wntrblm/winterbloom_kicad_library/README.md

# Winterbloom KiCAD libraries

This repository contains common schematic symbols, footprints, and 3D models
used in Winterbloom projects.

* [Symbols](symbols/winterbloom.md)
* [Footprints](footprints/winterbloom.md)

## License

Licensed under [Creative Commons CC-BY-SA 4.0](https://creativecommons.org/licenses/by-sa/4.0/legalcode). See [LICENSE](LICENSE) for more details.
