wntrblm/winterbloom_kicad_library/footprints/winterbloom.md

# Winterbloom

Footprint | Step
---|---
AudioJack_WQP518MA | [AudioJack_WQP518MA](${WINTERBLOOM3DMOD}/WQP-WQP518MA.step)
AudioJack_WQP518MA_Compact_S | [AudioJack_WQP518MA_Compact_S](${WINTERBLOOM3DMOD}/WQP-WQP518MA.step)
AudioJack_WQP518MA_Compact_S_LongPads | [AudioJack_WQP518MA_Compact_S_LongPads](${WINTERBLOOM3DMOD}/WQP-WQP518MA.step)
AudioJack_WQP518MA_LongPads | [AudioJack_WQP518MA_LongPads](${WINTERBLOOM3DMOD}/WQP-WQP518MA.step)
AudioJack_WQP518MA_No_S | [AudioJack_WQP518MA_No_S](${WINTERBLOOM3DMOD}/WQP-WQP518MA.step)
BarrelJack_CUI_PJ-102AH_Horizontal | [BarrelJack_CUI_PJ-102AH_Horizontal](${WINTERBLOOM3DMOD}/CUI_DEVICES_PJ-102A.step)
C_0402_HandSolder | [C_0402_HandSolder](${KICAD6_3DMODEL_DIR}/Capacitor_SMD.3dshapes/C_0402_1005Metric.wrl)
C_0603_HandSolder | [C_0603_HandSolder](${KICAD6_3DMODEL_DIR}/Capacitor_SMD.3dshapes/C_0603_1608Metric.wrl)
C_0805_HandSolder | [C_0805_HandSolder](${KICAD6_3DMODEL_DIR}/Capacitor_SMD.3dshapes/C_0805_2012Metric.wrl)
C_1206_HandSolder | [C_1206_HandSolder](${KICAD6_3DMODEL_DIR}/Capacitor_SMD.3dshapes/C_1206_3216Metric.wrl)
C_1210_HandSolder | [C_1210_HandSolder](${KICAD6_3DMODEL_DIR}/Capacitor_SMD.3dshapes/C_1210_3225Metric.wrl)
Connector_Cortex_Debug_IDC_2x05_P1.27mm_Vertical_Shrouded_SMD | [Connector_Cortex_Debug_IDC_2x05_P1.27mm_Vertical_Shrouded_SMD](${WINTERBLOOM3DMOD}/CNC_Tech_3220-10-0300-00.step)
Connector_FFC_1x05_P2.54mm_Vertical_LongPads | [Connector_FFC_1x05_P2.54mm_Vertical_LongPads]()
Connector_RJ45_ASSMANN_A-2014-2S-4-N-R | [Connector_RJ45_ASSMANN_A-2014-2S-4-N-R](${WINTERBLOOM3DMOD}/ASSMANN_A-2014-4-N-R.step)
Connector_RJ45_SS-7188S-A-PG4-BA-50 | [Connector_RJ45_SS-7188S-A-PG4-BA-50](${WINTERBLOOM3DMOD}/Belfuse-SS-7188S-A-PG4-BA-50.step)
Converter_DCDC_CUI_P78E-1000_THT | [Converter_DCDC_CUI_P78E-1000_THT](${WINTERBLOOM3DMOD}/CUI_P78E12-1000.step)
Converter_DCDC_CUI_V78E05-500-SMT | [Converter_DCDC_CUI_V78E05-500-SMT](${WINTERBLOOM3DMOD}/CUI_V78E05-500-SMT-TR.step)
Converter_DCDC_CUI_VX78-500_THT | [Converter_DCDC_CUI_VX78-500_THT](${WINTERBLOOM3DMOD}/CUI_VX7805-500.step)
Converter_DCDC_Murata_MYRGC | [Converter_DCDC_Murata_MYRGC]()
Crystal_SMD_HC49-US | [Crystal_SMD_HC49-US](${KISYS3DMOD}/Crystal.3dshapes/Crystal_SMD_HC49-SD.wrl)
D_SMA | [D_SMA](${KICAD6_3DMODEL_DIR}/Diode_SMD.3dshapes/D_SMA.wrl)
D_SOD-123 | [D_SOD-123](${WINTERBLOOM3DMOD}/SOD123W.step)
D_SOD-123+SOD-123F | [D_SOD-123+SOD-123F](${KISYS3DMOD}/Diode_SMD.3dshapes/D_SOD-123.wrl)
D_SOD-128 | [D_SOD-128](${WINTERBLOOM3DMOD}/SOD128.step)
D_SOD-323 | [D_SOD-323](${WINTERBLOOM3DMOD}/SOD323.step)
Eurorack_Power_2x5_Shrouded_Lock | [Eurorack_Power_2x5_Shrouded_Lock](${WINTERBLOOM3DMOD}/Eurorack_Power_2x5.step)
Eurorack_Power_2x5_Shrouded_Lock_LongPads | [Eurorack_Power_2x5_Shrouded_Lock_LongPads](${WINTERBLOOM3DMOD}/Eurorack_Power_2x5.step)
Eurorack_Power_2x8_Shrouded_Lock | [Eurorack_Power_2x8_Shrouded_Lock](${KICAD6_3DMODEL_DIR}/Connector_IDC.3dshapes/IDC-Header_2x08_P2.54mm_Vertical.wrl)
Fuse_Littelfuse_0805L | [Fuse_Littelfuse_0805L]()
JST_SH_SM04B-SRSS-TB_1x04-1MP_P1.00mm_Horizontal | [JST_SH_SM04B-SRSS-TB_1x04-1MP_P1.00mm_Horizontal](${WINTERBLOOM3DMOD}/JST-SH-SM04B-SRSS-TB.step)
JST_XH_B3B-XH-AM_1x03_P2.50mm_Vertical | [JST_XH_B3B-XH-AM_1x03_P2.50mm_Vertical](${WINTERBLOOM3DMOD}/JST-XH-B3B-A.step)
JST_XH_B4B-XH-AM_1x04_P2.50mm_Vertical | [JST_XH_B4B-XH-AM_1x04_P2.50mm_Vertical](${WINTERBLOOM3DMOD}/JST-XH-B4B-A.step)
Key_Switch_Cherry_MX_1.00u_PCB | [Key_Switch_Cherry_MX_1.00u_PCB](${WINTERBLOOM3DMOD}/Cherry_MX.step)
LED-APA102-2020 | [LED-APA102-2020](:WINTERBLOOM3DMOD:APA102-2020.step)
LED_0805_Kingbright_APT2012 | [LED_0805_Kingbright_APT2012](${WINTERBLOOM3DMOD}/AP2012.wrl)
LED_APA102_Dotstar_5050 | [LED_APA102_Dotstar_5050](${WINTERBLOOM3DMOD}/APA102_5050.step)
LED_SK9822-EC20_Dotstar_2020 | [LED_SK9822-EC20_Dotstar_2020]()
L_0402_HandSolder | [L_0402_HandSolder](${KICAD6_3DMODEL_DIR}/Inductor_SMD.3dshapes/L_0402_1005Metric.wrl)
L_0603_HandSolder | [L_0603_HandSolder](${KICAD6_3DMODEL_DIR}/Inductor_SMD.3dshapes/L_0603_1608Metric.wrl)
L_0805_HandSolder | [L_0805_HandSolder](${KICAD6_3DMODEL_DIR}/Inductor_SMD.3dshapes/L_0805_2012Metric.wrl)
Miniature_Switch_SPDT_2.54MM | [Miniature_Switch_SPDT_2.54MM]()
MountingHole_M3_Skinny | [MountingHole_M3_Skinny]()
MountingHole_M3_Slotted_Eurorack | [MountingHole_M3_Slotted_Eurorack]()
OSHW-Certification-Mark-Logo_12x6mm_CopperMask | [OSHW-Certification-Mark-Logo_12x6mm_CopperMask]()
OSHW-Certification-Mark-Logo_12x6mm_SilkMask | [OSHW-Certification-Mark-Logo_12x6mm_SilkMask]()
OSHW-Certification-Mark-Logo_12x6mm_SilkScreen | [OSHW-Certification-Mark-Logo_12x6mm_SilkScreen]()
OSHW-Certification-Mark-Logo_20x9mm_CopperMask | [OSHW-Certification-Mark-Logo_20x9mm_CopperMask]()
OSHW-Certification-Mark-Logo_20x9mm_SilkMask | [OSHW-Certification-Mark-Logo_20x9mm_SilkMask]()
OSHW-Certification-Mark-Logo_20x9mm_SilkScreen | [OSHW-Certification-Mark-Logo_20x9mm_SilkScreen]()
OSHW-Certification-Mark-Logo_30x14mm_CopperMask | [OSHW-Certification-Mark-Logo_30x14mm_CopperMask]()
OSHW-Certification-Mark-Logo_30x14mm_SilkMask | [OSHW-Certification-Mark-Logo_30x14mm_SilkMask]()
OSHW-Certification-Mark-Logo_30x14mm_SilkScreen | [OSHW-Certification-Mark-Logo_30x14mm_SilkScreen]()
OSHW-Certification-Mark-Logo_6x3mm_CopperMask | [OSHW-Certification-Mark-Logo_6x3mm_CopperMask]()
OSHW-Certification-Mark-Logo_6x3mm_SilkMask | [OSHW-Certification-Mark-Logo_6x3mm_SilkMask]()
OSHW-Certification-Mark-Logo_6x3mm_SilkScreen | [OSHW-Certification-Mark-Logo_6x3mm_SilkScreen]()
OSHW-Certification-Mark-Logo_8x4mm_CopperMask | [OSHW-Certification-Mark-Logo_8x4mm_CopperMask]()
OSHW-Certification-Mark-Logo_8x4mm_SilkMask | [OSHW-Certification-Mark-Logo_8x4mm_SilkMask]()
OSHW-Certification-Mark-Logo_8x4mm_SilkScreen | [OSHW-Certification-Mark-Logo_8x4mm_SilkScreen]()
OSHW-Certification-Mark-Stacked_12x10mm_CopperMask | [OSHW-Certification-Mark-Stacked_12x10mm_CopperMask]()
OSHW-Certification-Mark-Stacked_12x10mm_SilkMask | [OSHW-Certification-Mark-Stacked_12x10mm_SilkMask]()
OSHW-Certification-Mark-Stacked_12x10mm_SilkScreen | [OSHW-Certification-Mark-Stacked_12x10mm_SilkScreen]()
OSHW-Certification-Mark-Stacked_20x16mm_CopperMask | [OSHW-Certification-Mark-Stacked_20x16mm_CopperMask]()
OSHW-Certification-Mark-Stacked_20x16mm_SilkMask | [OSHW-Certification-Mark-Stacked_20x16mm_SilkMask]()
OSHW-Certification-Mark-Stacked_20x16mm_SilkScreen | [OSHW-Certification-Mark-Stacked_20x16mm_SilkScreen]()
OSHW-Certification-Mark-Stacked_30x24mm_CopperMask | [OSHW-Certification-Mark-Stacked_30x24mm_CopperMask]()
OSHW-Certification-Mark-Stacked_30x24mm_SilkMask | [OSHW-Certification-Mark-Stacked_30x24mm_SilkMask]()
OSHW-Certification-Mark-Stacked_30x24mm_SilkScreen | [OSHW-Certification-Mark-Stacked_30x24mm_SilkScreen]()
OSHW-Certification-Mark-Stacked_8x7mm_CopperMask | [OSHW-Certification-Mark-Stacked_8x7mm_CopperMask]()
OSHW-Certification-Mark-Stacked_8x7mm_SilkMask | [OSHW-Certification-Mark-Stacked_8x7mm_SilkMask]()
OSHW-Certification-Mark-Stacked_8x7mm_SilkScreen | [OSHW-Certification-Mark-Stacked_8x7mm_SilkScreen]()
OSHW-Certification-Mark-Wide_4x25mm_CopperMask | [OSHW-Certification-Mark-Wide_4x25mm_CopperMask]()
OSHW-Certification-Mark-Wide_4x25mm_SilkMask | [OSHW-Certification-Mark-Wide_4x25mm_SilkMask]()
OSHW-Certification-Mark-Wide_4x25mm_SilkScreen | [OSHW-Certification-Mark-Wide_4x25mm_SilkScreen]()
OSHW-Certification-Mark-Wide_6x35mm_CopperMask | [OSHW-Certification-Mark-Wide_6x35mm_CopperMask]()
OSHW-Certification-Mark-Wide_6x35mm_SilkMask | [OSHW-Certification-Mark-Wide_6x35mm_SilkMask]()
OSHW-Certification-Mark-Wide_6x35mm_SilkScreen | [OSHW-Certification-Mark-Wide_6x35mm_SilkScreen]()
OSHW-Certification-Mark-Wide_9x45mm_CopperMask | [OSHW-Certification-Mark-Wide_9x45mm_CopperMask]()
OSHW-Certification-Mark-Wide_9x45mm_SilkMask | [OSHW-Certification-Mark-Wide_9x45mm_SilkMask]()
OSHW-Certification-Mark-Wide_9x45mm_SilkScreen | [OSHW-Certification-Mark-Wide_9x45mm_SilkScreen]()
Potentiometer_Alpha_R0904N | [Potentiometer_Alpha_R0904N](${WINTERBLOOM3DMOD}/Alpha-RD901F-40-15R1.step)
Potentiometer_Alpha_R0904N_LongPads | [Potentiometer_Alpha_R0904N_LongPads](${WINTERBLOOM3DMOD}/Alpha-RD901F-40-15R1.step)
Potentiometer_Bourns_PTA45x3-2x | [Potentiometer_Bourns_PTA45x3-2x](${WINTERBLOOM3DMOD}/Bourns_PTA4543.step)
Potentiometer_Moog | [Potentiometer_Moog]()
QFN-20-3x5mm_MPM3610GQV | [QFN-20-3x5mm_MPM3610GQV]()
RJ45_Amphenol_RJE45-188-1411_Vertical | [RJ45_Amphenol_RJE45-188-1411_Vertical](${WINTERBLOOM3DMOD}/Amphenol-RJE45-188-1xx1.step)
RP2040-QFN-56 | [RP2040-QFN-56](${WINTERBLOOM3DMOD}/RP2040.step)
R_0402_HandSolder | [R_0402_HandSolder](${KICAD6_3DMODEL_DIR}/Resistor_SMD.3dshapes/R_0402_1005Metric.wrl)
R_0603_HandSolder | [R_0603_HandSolder](${KICAD6_3DMODEL_DIR}/Resistor_SMD.3dshapes/R_0603_1608Metric.wrl)
R_0805_HandSolder | [R_0805_HandSolder](${KICAD6_3DMODEL_DIR}/Resistor_SMD.3dshapes/R_0805_2012Metric.wrl)
R_1206_HandSolder | [R_1206_HandSolder](${KICAD6_3DMODEL_DIR}/Resistor_SMD.3dshapes/R_1206_3216Metric.wrl)
R_1210_HandSolder | [R_1210_HandSolder](${KICAD6_3DMODEL_DIR}/Resistor_SMD.3dshapes/R_1210_3225Metric.wrl)
SOIC-8+DMP-8_5mmx5mm_P1.27mm | [SOIC-8+DMP-8_5mmx5mm_P1.27mm](${KICAD8_3DMODEL_DIR}/Package_SO.3dshapes/SOIC-8_3.9x4.9mm_P1.27mm.wrl)
SolderWirePad_1x04_SMD_2x5mm | [SolderWirePad_1x04_SMD_2x5mm]()
Switch_DPDT_Thonk_DW4_P2.54mm | [Switch_DPDT_Thonk_DW4_P2.54mm]()
Symbol_CE_5x3.5mm_SilkScreen | [Symbol_CE_5x3.5mm_SilkScreen]()
Symbol_Ermine_15mm | [Symbol_Ermine_15mm]()
Symbol_Winterbloom_25mm | [Symbol_Winterbloom_25mm]()
Symbol_Winterbloom_40mm | [Symbol_Winterbloom_40mm]()
TDFN-8-1EP_MAX9717xET | [TDFN-8-1EP_MAX9717xET]()
TI-DGN-HVSSOP-8_3.0x3.0mm_P0.65mm | [TI-DGN-HVSSOP-8_3.0x3.0mm_P0.65mm](${KISYS3DMOD}/Package_SO.3dshapes/VSSOP-8_3.0x3.0mm_P0.65mm.wrl)
TMC2209-LA | [TMC2209-LA](${WINTERBLOOM3DMOD}/TMC2209_QFN28_5x5mm.step)
TQFP-48_7x7mm_P0.5mm | [TQFP-48_7x7mm_P0.5mm](${KISYS3DMOD}/Package_QFP.3dshapes/TQFP-48_7x7mm_P0.5mm.wrl)
Tactile_Switch_4.2mm | [Tactile_Switch_4.2mm](${WINTERBLOOM3DMOD}/Tactile_Switch_4.2mm.step)
Tactile_Switch_6mm | [Tactile_Switch_6mm](${WINTERBLOOM3DMOD}/E-Switch_TL1105TFxxxx.step)
Tag_Connect_TC2030NL | [Tag_Connect_TC2030NL]()
TerminalBlock_4UCON_1x02_P3.50mm_Horizontal | [TerminalBlock_4UCON_1x02_P3.50mm_Horizontal](${WINTERBLOOM3DMOD}/Terminal_Block_01x02.step)
TerminalBlock_CUI_TB002-500_1x02_P5.00mm_Vertical | [TerminalBlock_CUI_TB002-500_1x02_P5.00mm_Vertical](${WINTERBLOOM3DMOD}/CUI_DEVICES_TB002-500-02BE.step)
USB_B_Micro_Receptacle | [USB_B_Micro_Receptacle](${WINTERBLOOM3DMOD}/USB_B_Micro_Receptacle.igs)
USB_B_Receptacle | [USB_B_Receptacle](${WINTERBLOOM3DMOD}/USB_B_Receptacle.step)
USB_B_Receptacle_Horizontal | [USB_B_Receptacle_Horizontal](${WINTERBLOOM3DMOD}/Stewart-SS-52300-001.step)
USB_C_Vertical_GT-USB-7038X | [USB_C_Vertical_GT-USB-7038X](:WINTERBLOOM3DMOD:G-Switch_GT-USB-7038B.step)
Vishay_SOT-23_8 | [Vishay_SOT-23_8](${KICAD6_3DMODEL_DIR}/Package_TO_SOT_SMD.3dshapes/TSOT-23-8.wrl)
XGZP6857D | [XGZP6857D](${WINTERBLOOM3DMOD}/XGZP6857D.step)
IND_1255AY-220M=P3 | [IND_1255AY-220M=P3]()
IND_SDR0403-180ML | [IND_SDR0403-180ML]()
QFN+QFP-64-SAMD51 | [QFN+QFP-64-SAMD51](${KISYS3DMOD}/Package_DFN_QFN.3dshapes/QFN-64-1EP_9x9mm_P0.5mm_EP3.8x3.8mm.wrl)
