wntrblm/winterbloom_kicad_library/symbols/winterbloom.md

# Winterbloom

Symbol | Datasheet | Footprint
---|---|---
74HC2G34 | [74HC2G34](https://assets.nexperia.com/documents/data-sheet/74HC_HCT2G34.pdf) | Package_TO_SOT_SMD:SOT-363_SC-70-6
74LVC1G04 | [74LVC1G04](https://www.ti.com/lit/ds/symlink/sn74lvc1g04.pdf) | Package_TO_SOT_SMD:SOT-23-5
74LVC2G74 | [74LVC2G74](https://assets.nexperia.com/documents/data-sheet/74LVC2G74.pdf) | 
8.0 | [8.0]() | 
AD5686RxRUZ | [AD5686RxRUZ](https://www.analog.com/media/en/technical-documentation/data-sheets/ad5686r_5685r_5684r.pdf) | Package_SO:TSSOP-16_4.4x5mm_P0.65mm
ADG1208 | [ADG1208](https://www.analog.com/media/en/technical-documentation/data-sheets/ADG1208_1209.pdf) | Package_SO:TSSOP-16_4.4x5mm_P0.65mm
ADG1209 | [ADG1209](https://www.analog.com/media/en/technical-documentation/data-sheets/ADG1208_1209.pdf) | Package_SO:TSSOP-16_4.4x5mm_P0.65mm
ADG1308 | [ADG1308](https://www.analog.com/media/en/technical-documentation/data-sheets/ADG1308_1309.pdf) | Package_SO:TSSOP-16_4.4x5mm_P0.65mm
ADG1309 | [ADG1309](https://www.analog.com/media/en/technical-documentation/data-sheets/ADG1308_1309.pdf) | Package_SO:TSSOP-16_4.4x5mm_P0.65mm
APA102-2020_Dotstar | [APA102-2020_Dotstar](https://cdn-shop.adafruit.com/product-files/3341/3341_APA102-2020+SMD+LED.pdf) | LED_SMD:LED-APA102-2020
ATSAMD21G18A-A | [ATSAMD21G18A-A](http://ww1.microchip.com/downloads/en/DeviceDoc/SAM_D21_DA1_Family_Data%20Sheet_DS40001882E.pdf) | winterbloom:TQFP-48_7x7mm_P0.5mm
ATSAMD51J20A-M | [ATSAMD51J20A-M](https://ww1.microchip.com/downloads/en/DeviceDoc/SAM_D5x_E5x_Family_Data_Sheet_DS60001507G.pdf) | Package_DFN_QFN:QFN-64-1EP_9x9mm_P0.5mm_EP3.8x3.8mm
ATSAMD51P20A-A | [ATSAMD51P20A-A](http://ww1.microchip.com/downloads/en/DeviceDoc/60001507E.pdf) | Package_QFP:TQFP-128_14x14mm_P0.4mm
BCM847 | [BCM847](https://assets.nexperia.com/documents/data-sheet/BCM847BS.pdf) | Package_TO_SOT_SMD:SOT-363_SC-70-6
Conn_01x04_MountingPin2 | [Conn_01x04_MountingPin2](~) | Connector_JST:JST_PH_S4B-PH-SM4-TB_1x04-1MP_P2.00mm_Horizontal
Conn_SWD | [Conn_SWD](http://infocenter.arm.com/help/topic/com.arm.doc.ddi0314h/DDI0314H_coresight_components_trm.pdf) | winterbloom:Connector_Cortex_Debug_IDC_2x05_P1.27mm_Vertical_Shrouded_SMD
Crystal_12MHz_4Pin | [Crystal_12MHz_4Pin](https://abracon.com/datasheets/ABM8G-106-12.000MHz-T.pdf) | Crystal:Crystal_SMD_Abracon_ABM8G-4Pin_3.2x2.5mm
DG449 | [DG449](https://www.vishay.com/docs/73897/dg449.pdf) | winterbloom:Vishay_SOT-23_8
DRV103U | [DRV103U](https://www.ti.com/lit/ds/symlink/drv103.pdf) | Package_SO:SOIC-8_3.9x4.9mm_P1.27mm
DRV120PWR | [DRV120PWR](https://www.ti.com/lit/ds/symlink/drv120.pdf) | Package_SO:TSSOP-8_4.4x3mm_P0.65mm
Dotstar | [Dotstar](https://www.alibaba.com/product-detail/High-Efficiency-SK9822-Similar-APA102-5050_62326807400.html) | winterbloom:LED_APA102_Dotstar_5050
Eurorack_Mono_Jack | [Eurorack_Mono_Jack](http://www.qingpu-electronics.com/en/products/WQP-PJ398SM-362.html) | winterbloom:AudioJack_WQP518MA
Eurorack_Mono_Jack_No_S | [Eurorack_Mono_Jack_No_S](http://www.qingpu-electronics.com/en/products/WQP-PJ398SM-362.html) | winterbloom:AudioJack_WQP518MA_No_S
Eurorack_Pot | [Eurorack_Pot](https://s3.us-west-2.amazonaws.com/secure.notion-static.com/c2e29654-9937-4f21-ad37-19aeb30b6cf7/R0904N%28KQ%29-LWS.pdf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) | winterbloom:Potentiometer_Alpha_R0904N
Eurorack_Power | [Eurorack_Power](https://static6.arrow.com/aropdfconversion/1507f1621f4e67855dd466ebb3ac550d52564a9d/32302-sxx1.pdf) | winterbloom:Eurorack_Power_2x5_Shrouded_Lock
GD25Q64CWIGR | [GD25Q64CWIGR](http://www.gigadevice.com/datasheet/gd25q64c/) | Package_SON:WSON-8-1EP_6x5mm_P1.27mm_EP3.4x4mm
LM1117-3.3 | [LM1117-3.3](http://www.ti.com/lit/ds/symlink/lm1117.pdf) | Package_TO_SOT_SMD:SOT-223-3_TabPin2
LM358PWR | [LM358PWR](https://www.ti.com/lit/ds/symlink/lm358.pdf) | Package_SO:TSSOP-8_4.4x3mm_P0.65mm
LM4040-10 | [LM4040-10](http://www.ti.com/lit/ds/symlink/lm4040-n.pdf) | Package_TO_SOT_SMD:SOT-23
LM4040DBZ-10 | [LM4040DBZ-10](http://www.ti.com/lit/ds/symlink/lm4040-n.pdf) | Package_TO_SOT_SMD:SOT-23
LSM6DSO | [LSM6DSO](https://www.st.com/resource/en/datasheet/lsm6dso.pdf) | Package_LGA:LGA-14_3x2.5mm_P0.5mm_LayoutBorder3x4y
MAX9717x | [MAX9717x](https://datasheets.maximintegrated.com/en/ds/MAX9716-MAX9717.pdf) | winterbloom:TDFN-8-1EP_MAX9717xET
MAX97220C | [MAX97220C](https://www.mouser.com/datasheet/2/256/MAX97220A-MAX97220E-5002.pdf) | Package_DFN_QFN:TQFN-16-1EP_3x3mm_P0.5mm_EP1.23x1.23mm_ThermalVias
MAX98357A | [MAX98357A](https://datasheets.maximintegrated.com/en/ds/MAX98357A-MAX98357B.pdf) | Package_DFN_QFN:QFN-16-1EP_3x3mm_P0.5mm_EP1.45x1.45mm
MCP4728 | [MCP4728](http://ww1.microchip.com/downloads/en/DeviceDoc/22187E.pdf) | Package_SO:MSOP-10_3x3mm_P0.5mm
MCP6001-OT | [MCP6001-OT](http://ww1.microchip.com/downloads/en/DeviceDoc/22141b.pdf) | Package_TO_SOT_SMD:SOT-23-5
MCP6002 | [MCP6002](https://ww1.microchip.com/downloads/en/DeviceDoc/MCP6001-1R-1U-2-4-1-MHz-Low-Power-Op-Amp-DS20001733L.pdf) | Package_SO:MSOP-8_3x3mm_P0.65mm
MCP6004 | [MCP6004](http://datasheet.octopart.com/MCP6001T-I/OT-Microchip-datasheet-8823409.pdf) | Package_SO:TSSOP-14_4.4x5mm_P0.65mm
MIC5317 | [MIC5317](https://www.mouser.com/datasheet/2/268/MIC5317_High_Performance_Single_150mA_LDO_DS200061-1891237.pdf) | Package_TO_SOT_SMD:SOT-23-5
MIC5319 | [MIC5319](https://ww1.microchip.com/downloads/en/DeviceDoc/500mA-uCap-Ultra-Low-Dropout-Regulator-with-High-PSRR-DS20005876B.pdf) | Package_TO_SOT_SMD:SOT-23-5
MPM3610 | [MPM3610](https://www.monolithicpower.com/en/mpm3610.html) | 
MUX508 | [MUX508](https://www.ti.com/lit/ds/symlink/mux508.pdf) | Package_SO:TSSOP-16_4.4x5mm_P0.65mm
MUX509 | [MUX509](https://www.ti.com/lit/ds/symlink/mux509.pdf) | Package_SO:TSSOP-16_4.4x5mm_P0.65mm
MYRGC | [MYRGC](https://www.mouser.com/datasheet/2/281/MYRGC-1701768.pdf) | 
OPA4197 | [OPA4197](https://www.ti.com/lit/ds/symlink/opa4197.pdf) | Package_SO:TSSOP-14_4.4x5mm_P0.65mm
OPA4991 | [OPA4991](https://www.ti.com/lit/ds/symlink/opa4991.pdf) | Package_SO:TSSOP-14_4.4x5mm_P0.65mm
P78E-1000 | [P78E-1000](https://www.mouser.com/datasheet/2/670/p78e_1000-1480573.pdf) | 
PAM8302AAS | [PAM8302AAS](https://www.diodes.com/assets/Datasheets/PAM8302A.pdf) | winterbloom:TDFN-8-1EP_MAX9717xET
PCA9545 | [PCA9545](https://www.nxp.com/docs/en/data-sheet/PCA9545A_45B_45C.pdf) | Package_SO:TSSOP-20_4.4x6.5mm_P0.65mm
RP2040 | [RP2040](https://datasheets.raspberrypi.com/rp2040/rp2040-datasheet.pdf) | winterbloom:RP2040-QFN-56
SSM2604 | [SSM2604](https://www.analog.com/media/en/technical-documentation/data-sheets/SSM2604.pdf) | Package_CSP:LFCSP-20-1EP_4x4mm_P0.5mm_EP2.6x2.6mm
Switch_3PDT | [Switch_3PDT](~) | 
TC1044SxOA | [TC1044SxOA](http://ww1.microchip.com/downloads/en/DeviceDoc/21469a.pdf) | Package_SO:SOIC-8_3.9x4.9mm_P1.27mm
TL074 | [TL074](https://www.ti.com/lit/ds/symlink/tl071.pdf) | Package_SO:TSSOP-14_4.4x5mm_P0.65mm
TLV76733 | [TLV76733](https://www.ti.com/lit/ds/symlink/tlv767.pdf) | Package_SO:VSSOP-8_3.0x3.0mm_P0.65mm
TMC2209 | [TMC2209]() | 
TMUX6208 | [TMUX6208](https://www.ti.com/lit/ds/symlink/tmux6208.pdf) | Package_SO:TSSOP-16_4.4x5mm_P0.65mm
TMUX6209 | [TMUX6209](https://www.ti.com/lit/ds/symlink/tmux6209.pdf) | Package_SO:TSSOP-16_4.4x5mm_P0.65mm
TPD2EUSB30A | [TPD2EUSB30A](http://www.ti.com/lit/ds/symlink/tpd2eusb30a.pdf) | Package_TO_SOT_SMD:Texas_DRT-3
Tactile_Switch | [Tactile_Switch](https://factory.macrofab.com/part/MF-SW-TACT-4.2MM) | winterbloom:Tactile_Switch_4.2mm
Tag-Connect_SWD_TC2030 | [Tag-Connect_SWD_TC2030](https://www.tag-connect.com/product/tc2030-ctx-nl-6-pin-no-legs-cable-with-10-pin-micro-connector-for-cortex-processors~) | winterbloom:Tag_Connect_TC2030NL
USBLC6-2SC6 | [USBLC6-2SC6](https://www.st.com/resource/en/datasheet/usblc6-2.pdf) | Package_TO_SOT_SMD:SOT-23-6
USB_B_Micro_Receptacle | [USB_B_Micro_Receptacle](https://cdn.amphenol-cs.com/media/wysiwyg/files/documentation/datasheet/inputoutput/io_usb_micro.pdf) | winterbloom:USB_B_Micro_Receptacle
USB_B_Receptacle | [USB_B_Receptacle](https://www.te.com/commerce/DocumentDelivery/DDEController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) | winterbloom:USB_B_Receptacle
USB_C_Receptacle_USB2.0 | [USB_C_Receptacle_USB2.0](https://www.usb.org/sites/default/files/documents/usb_type-c.zip) | 
V78E05-500-SMT | [V78E05-500-SMT](https://www.cui.com/product/resource/v78e-500-smt.pdf) | winterbloom:V78E05-500-SMT
VX7805-500 | [VX7805-500](https://www.mouser.com/datasheet/2/670/vx78_500-1774570.pdf) | 
W25Q128JVSIQ | [W25Q128JVSIQ](https://www.winbond.com/resource-files/w25q128jv%20revf%2003272018%20plus.pdf) | Package_SO:SOIC-8_5.23x5.23mm_P1.27mm
XGZP6857D | [XGZP6857D](https://www.cfsensor.com/static/upload/file/20220412/XGZP6857D%20Pressure%20Sensor%20Module%20V2.4.pdf) | winterbloom:XGZP6857D
