wntrblm/winterbloom_kicad_library/3dmodels/CUI_V78E05-500-SMT.step

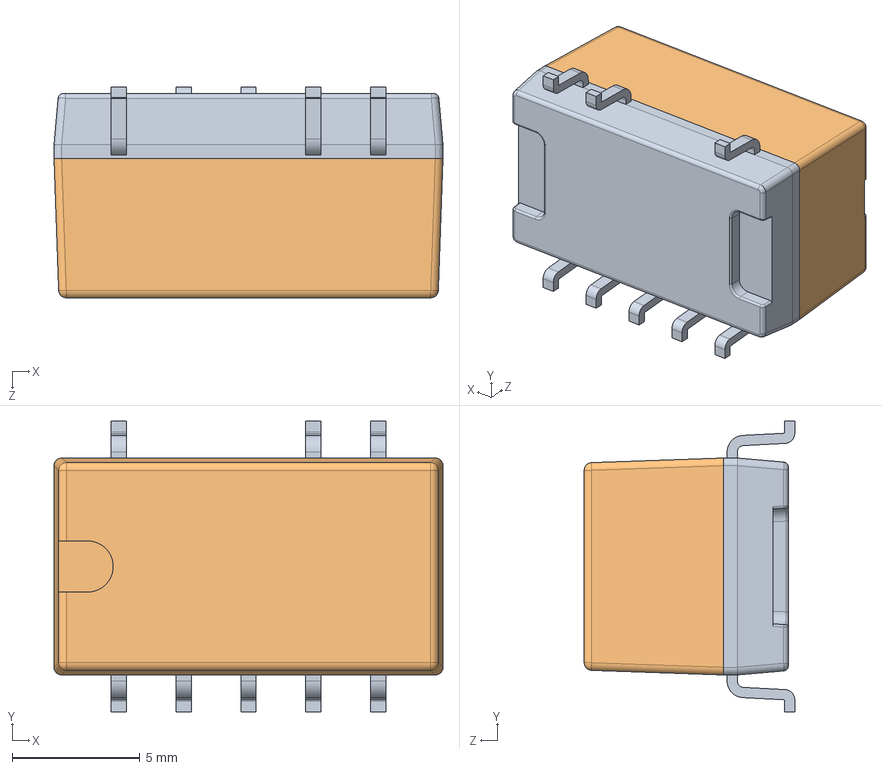
[picture p1: CAD file, 2024-07-16]
3dmodels/CUI_V78E05-500-SMT.step
15.2 x 11.4 x 8.25 mm
