wntrblm/winterbloom_kicad_library/3dmodels/Alps_RK09L12-L15V.step

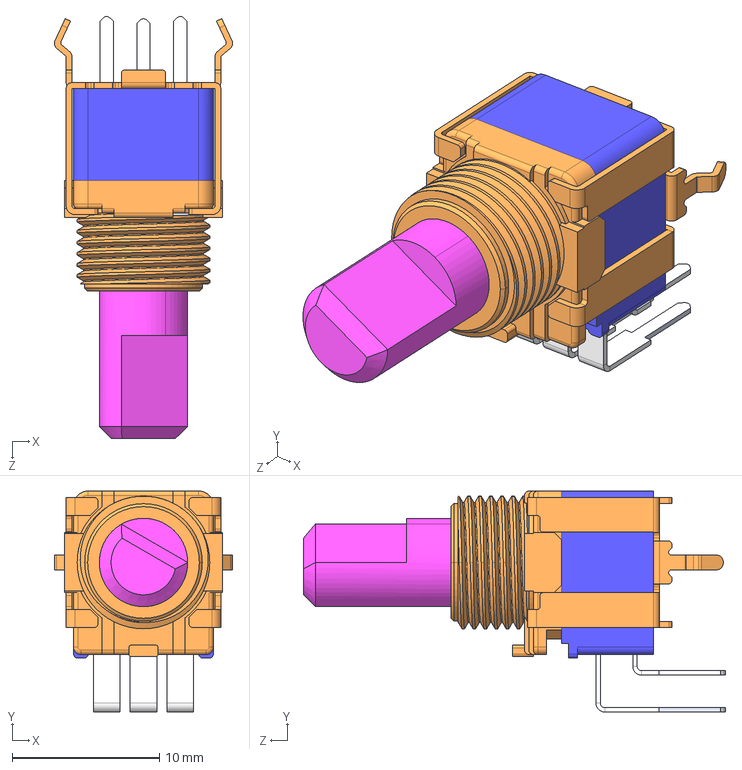
[picture p2: CAD file, 2024-07-16]
3dmodels/Alps_RK09L12-L15V.step
12.1 x 15.0 x 28.6 mm
