wntrblm/winterbloom_kicad_library/3dmodels/Neutrik_NMJ4HCD2.step

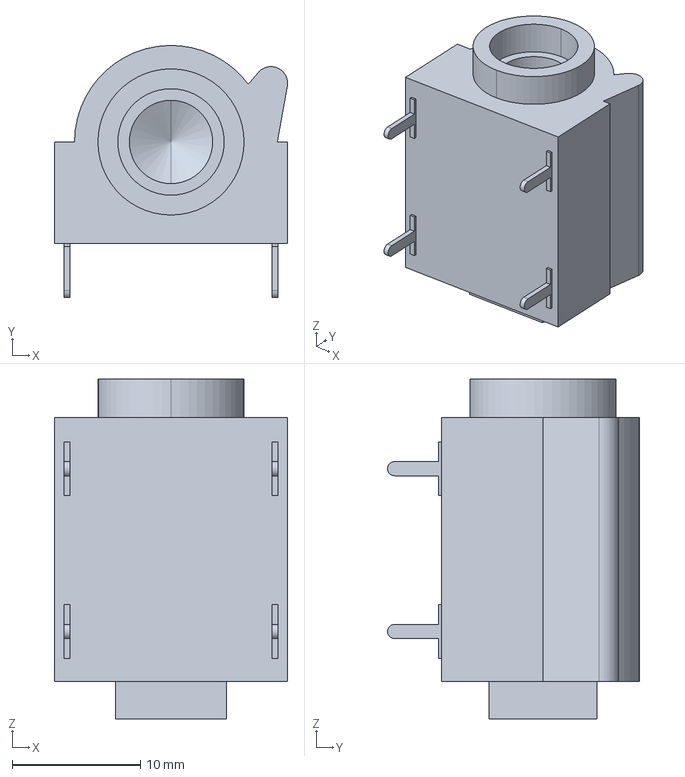
[picture p3: CAD file, 2024-02-03]
3dmodels/Neutrik_NMJ4HCD2.step
18.2 x 19.7 x 26.5 mm
