wntrblm/winterbloom_kicad_library/3dmodels/APA102-2020.step

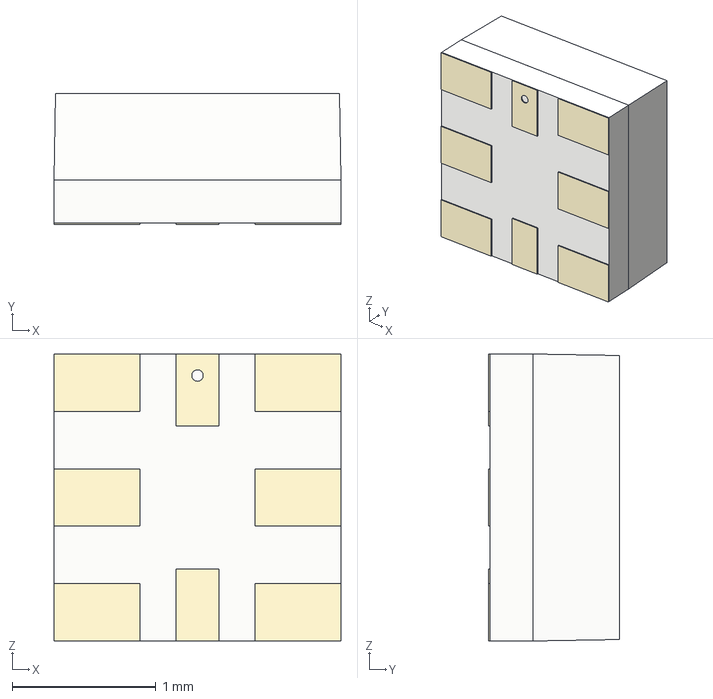
[picture p4: CAD file, 2023-09-24]
3dmodels/APA102-2020.step
2.00 x 0.91 x 2.00 mm
