wntrblm/winterbloom_kicad_library/3dmodels/JST-SH-SM05B-SRSS-TB.step

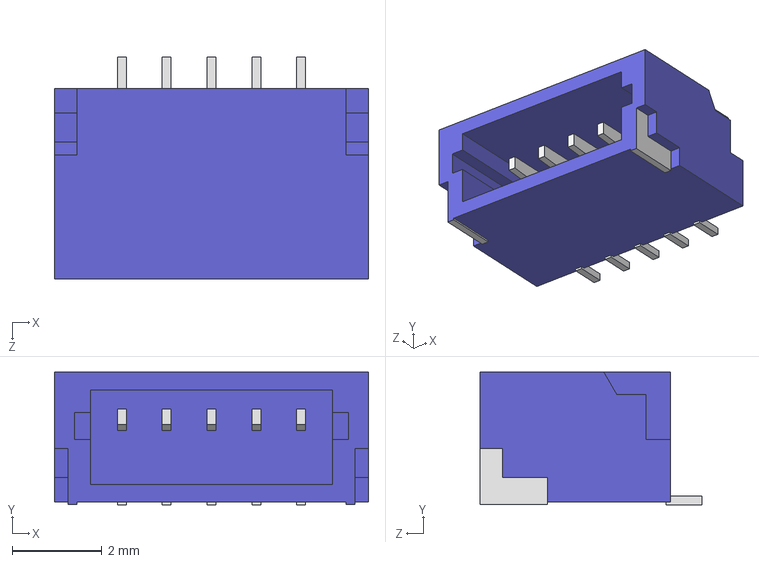
[picture p5: CAD file, 2023-09-24]
3dmodels/JST-SH-SM05B-SRSS-TB.step
7.00 x 2.96 x 4.95 mm
