wntrblm/winterbloom_kicad_library/3dmodels/G-Switch_GT-USB-7038D.step

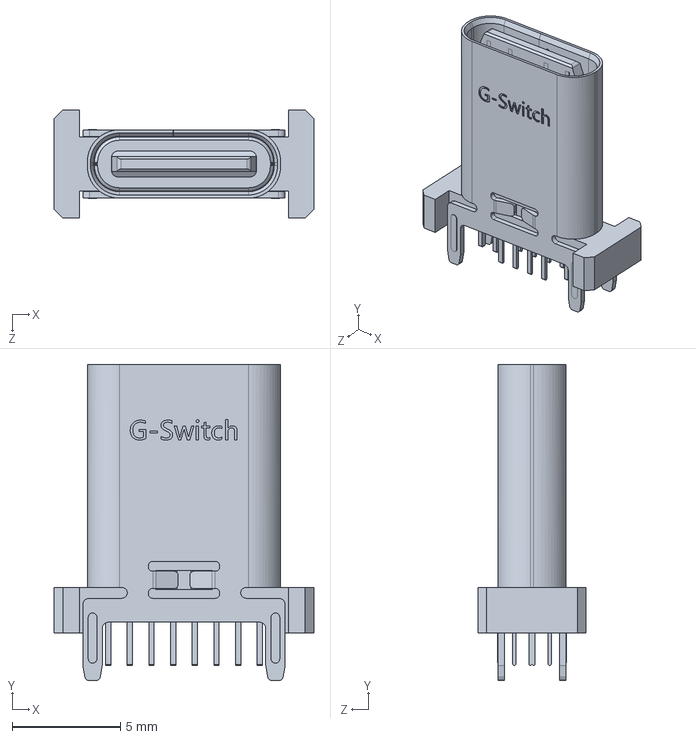
[picture p6: CAD file, 2023-09-23]
3dmodels/G-Switch_GT-USB-7038D.step
12.0 x 14.6 x 5.00 mm
