wntrblm/winterbloom_kicad_library/3dmodels/G-Switch_GT-USB-7038B.step

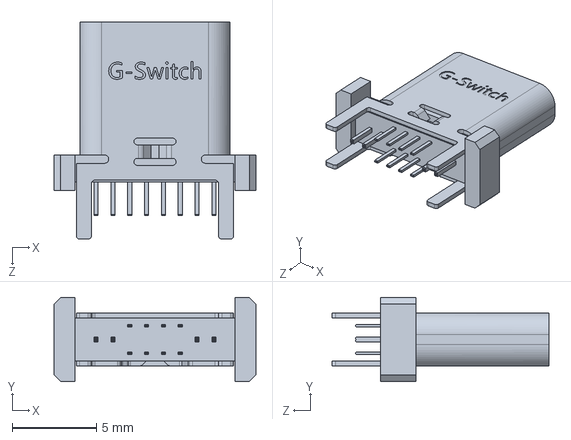
[picture p7: CAD file, 2023-09-23]
3dmodels/G-Switch_GT-USB-7038B.step
12.0 x 5.00 x 12.9 mm
