wntrblm/winterbloom_kicad_library/3dmodels/WQP-WQP518MA.step

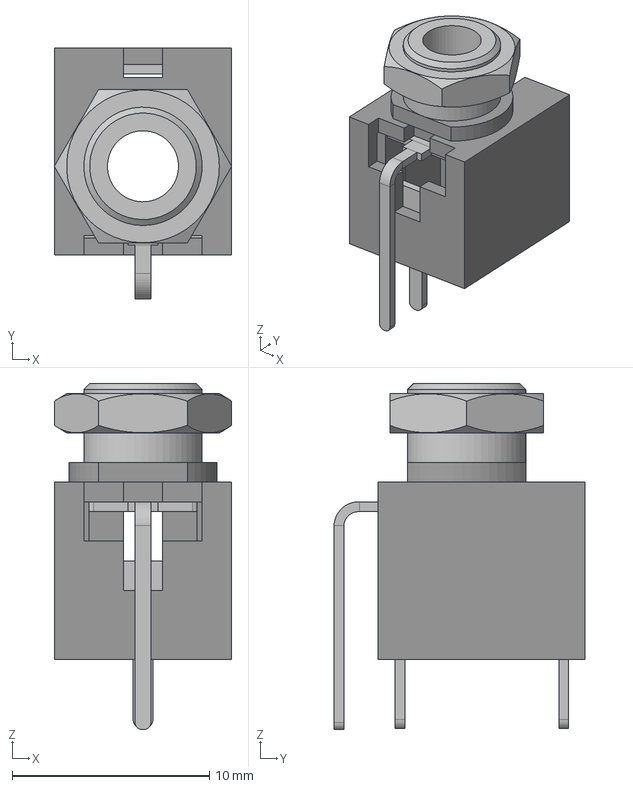
[picture p8: CAD file, 2023-08-08]
3dmodels/WQP-WQP518MA.step
9.00 x 12.7 x 17.6 mm
