wntrblm/winterbloom_kicad_library/3dmodels/E-Switch_TL1105TFxxxx.step

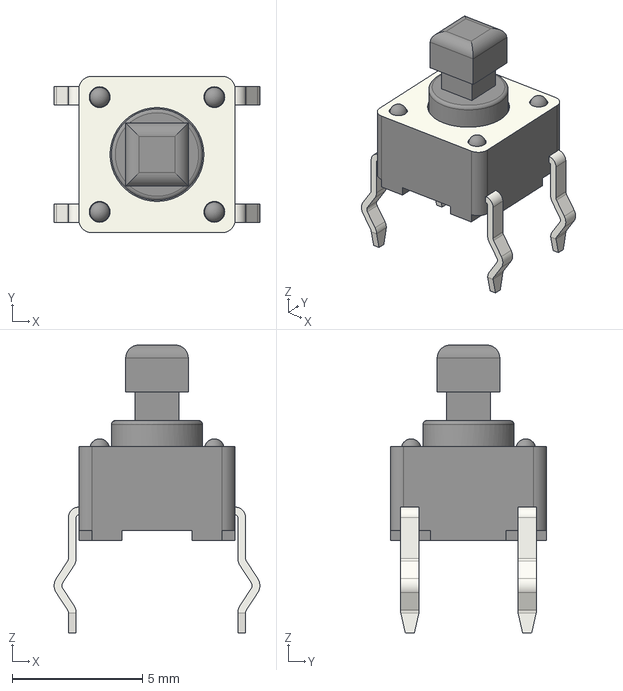
[picture p9: CAD file, 2023-08-08]
3dmodels/E-Switch_TL1105TFxxxx.step
7.89 x 6.00 x 11.1 mm
