wntrblm/winterbloom_kicad_library/3dmodels/Belfuse-SS-7188S-A-PG4-BA-50.step

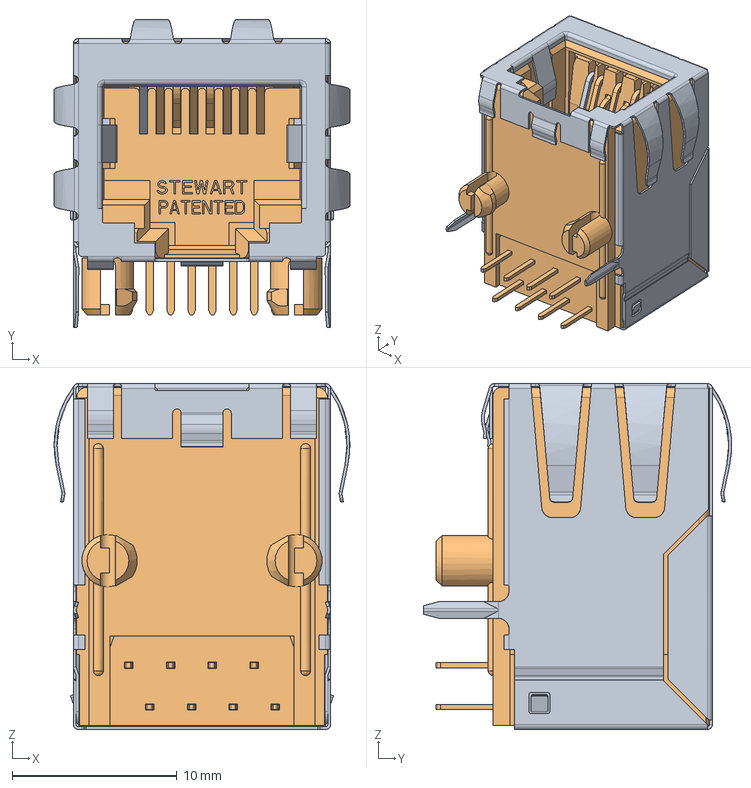
[picture p10: CAD file, 2022-09-14]
3dmodels/Belfuse-SS-7188S-A-PG4-BA-50.step
18.0 x 18.7 x 21.0 mm
SS-7188S-A-PG4-BA-50_PART4
SS-7188S-A-PG4-BA-50_PART3
SS-7188S-A-PG4-BA-50_PART2
SS-7188S-A-PG4-BA-50_PART1
