wntrblm/winterbloom_kicad_library/3dmodels/JST-XH-B3B-A.step

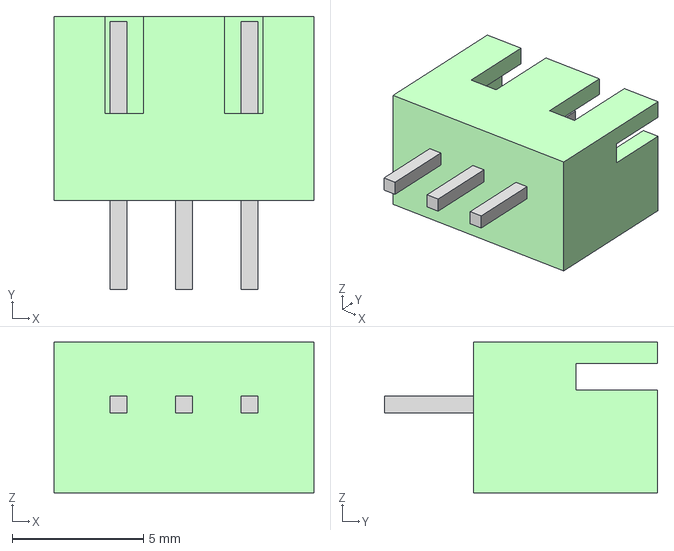
[picture p11: CAD file, 2022-09-14]
3dmodels/JST-XH-B3B-A.step
9.90 x 10.4 x 5.75 mm
