wntrblm/winterbloom_kicad_library/3dmodels/JST-SH-BM03B-SRSS-TB.step

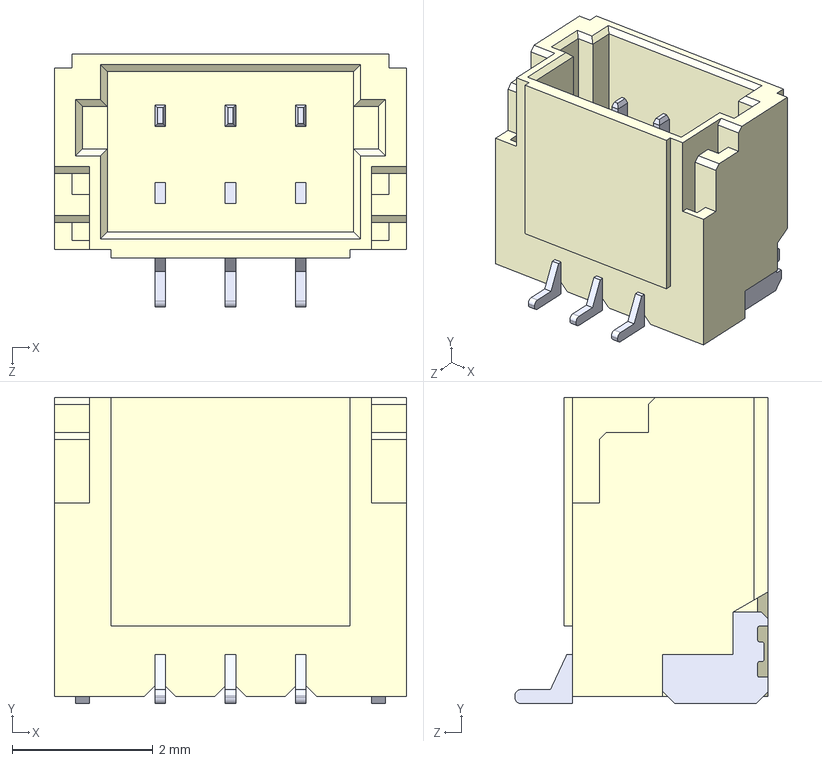
[picture p12: CAD file, 2022-09-14]
3dmodels/JST-SH-BM03B-SRSS-TB.step
5.00 x 4.35 x 3.60 mm
