wntrblm/winterbloom_kicad_library/3dmodels/Amphenol-RJE45-188-1xx1.step

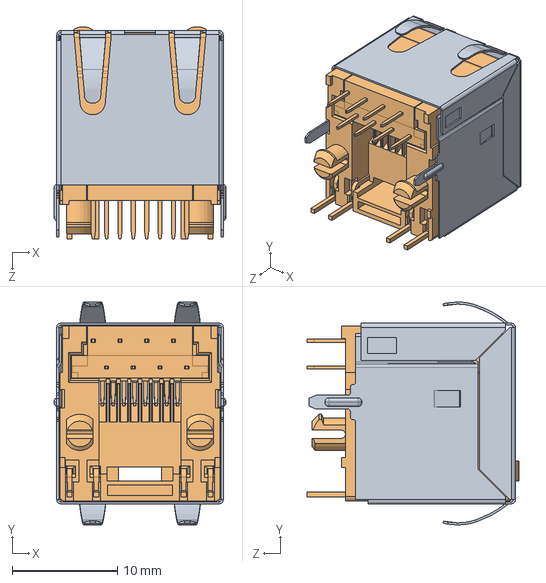
[picture p13: CAD file, 2022-09-14]
3dmodels/Amphenol-RJE45-188-1xx1.step
16.3 x 21.2 x 20.2 mm
