wntrblm/winterbloom_kicad_library/3dmodels/SOD323.step

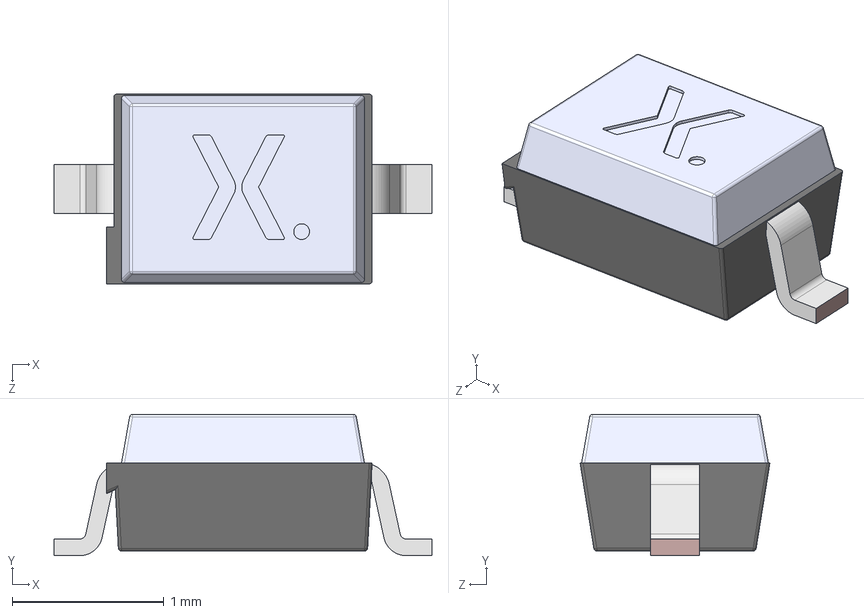
[picture p14: CAD file, 2022-09-14]
3dmodels/SOD323.step
2.49 x 0.93 x 1.25 mm
SOD323 Lower body
SOD323 Lead x 2
SOD323 Upper body
