wntrblm/winterbloom_kicad_library/3dmodels/Stewart-SS-52300-001.step

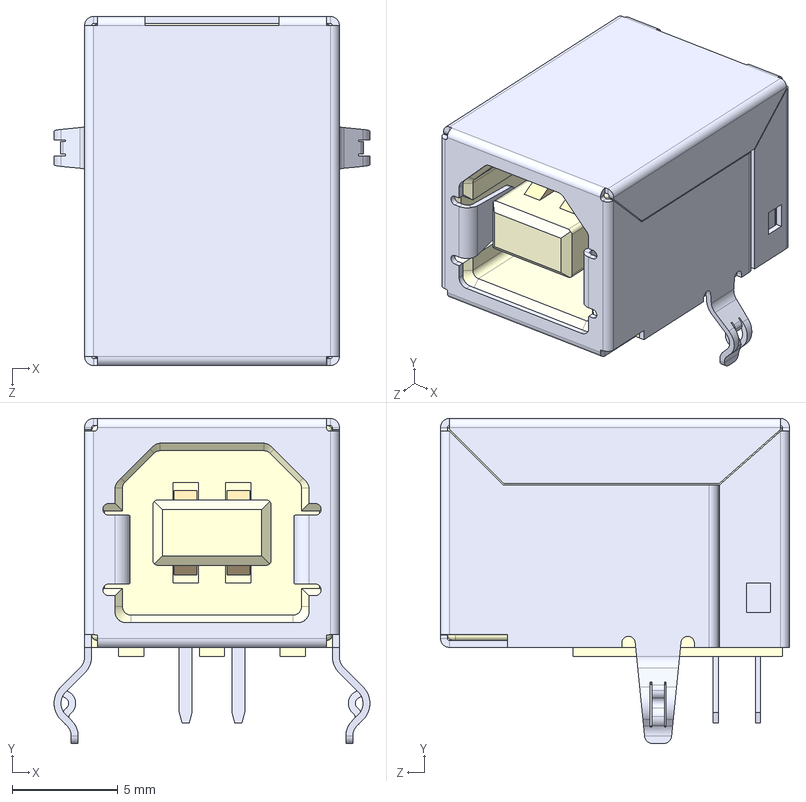
[picture p15: CAD file, 2022-09-14]
3dmodels/Stewart-SS-52300-001.step
14.9 x 15.4 x 16.5 mm
