wntrblm/winterbloom_kicad_library/3dmodels/JST-SH-SM04B-SRSS-TB.step

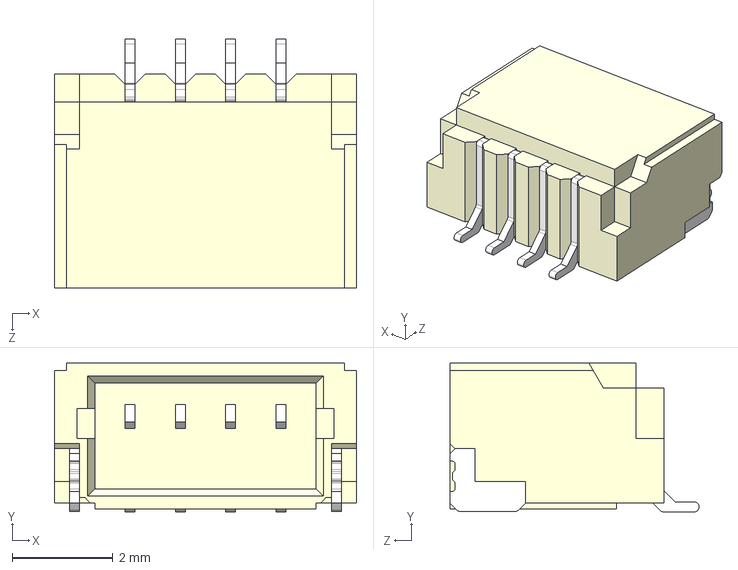
[picture p16: CAD file, 2022-09-14]
3dmodels/JST-SH-SM04B-SRSS-TB.step
6.00 x 2.96 x 4.95 mm
