wntrblm/winterbloom_kicad_library/3dmodels/SOD128.step

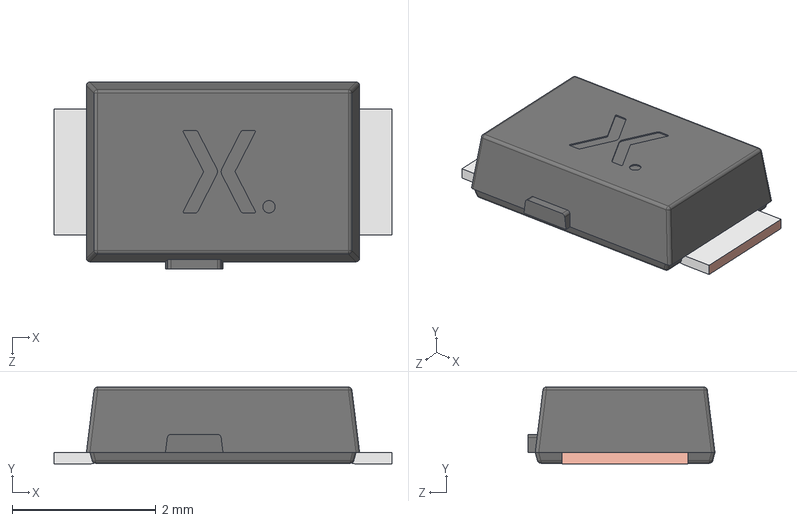
[picture p17: CAD file, 2022-09-14]
3dmodels/SOD128.step
4.70 x 1.07 x 2.60 mm
SOD128 Lead
SOD128 Lower body
SOD128 Upper body
