wntrblm/winterbloom_kicad_library/3dmodels/CUI_DEVICES_TB002-500-02BE.step

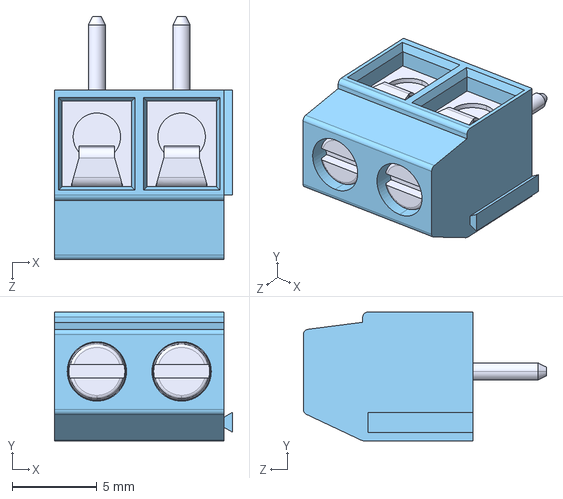
[picture p18: CAD file, 2022-09-14]
3dmodels/CUI_DEVICES_TB002-500-02BE.step
10.5 x 7.60 x 14.4 mm
