wntrblm/winterbloom_kicad_library/3dmodels/JST-SH-BM04B-SRSS-TB.step

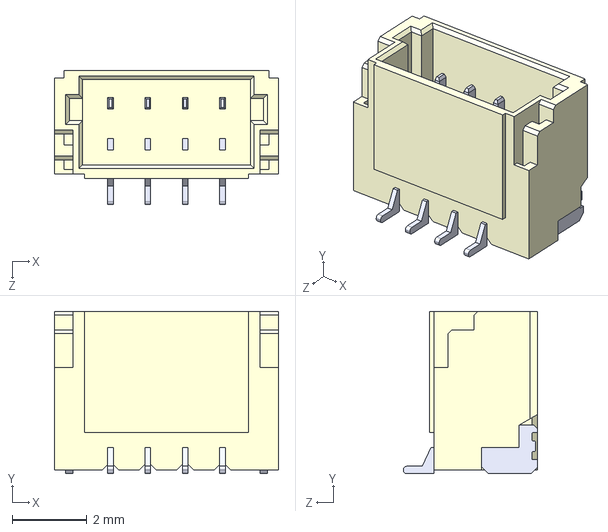
[picture p19: CAD file, 2022-09-14]
3dmodels/JST-SH-BM04B-SRSS-TB.step
6.00 x 4.35 x 3.60 mm
