wntrblm/winterbloom_kicad_library/3dmodels/JST-SH-BM05B-SRSS-TB.step

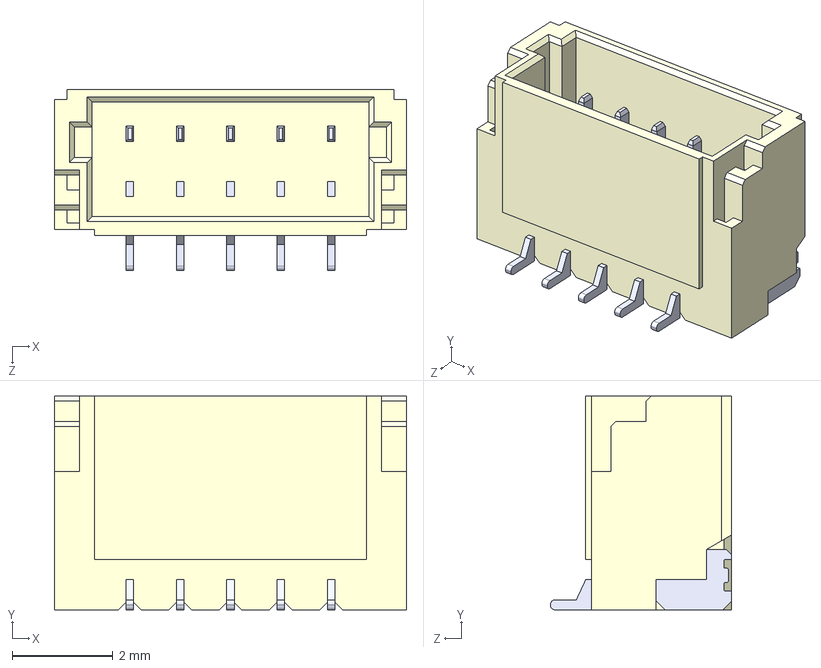
[picture p20: CAD file, 2022-09-14]
3dmodels/JST-SH-BM05B-SRSS-TB.step
7.00 x 4.25 x 3.60 mm
