wntrblm/winterbloom_kicad_library/3dmodels/JST-PH-S4B-PH-SM4-TB.step

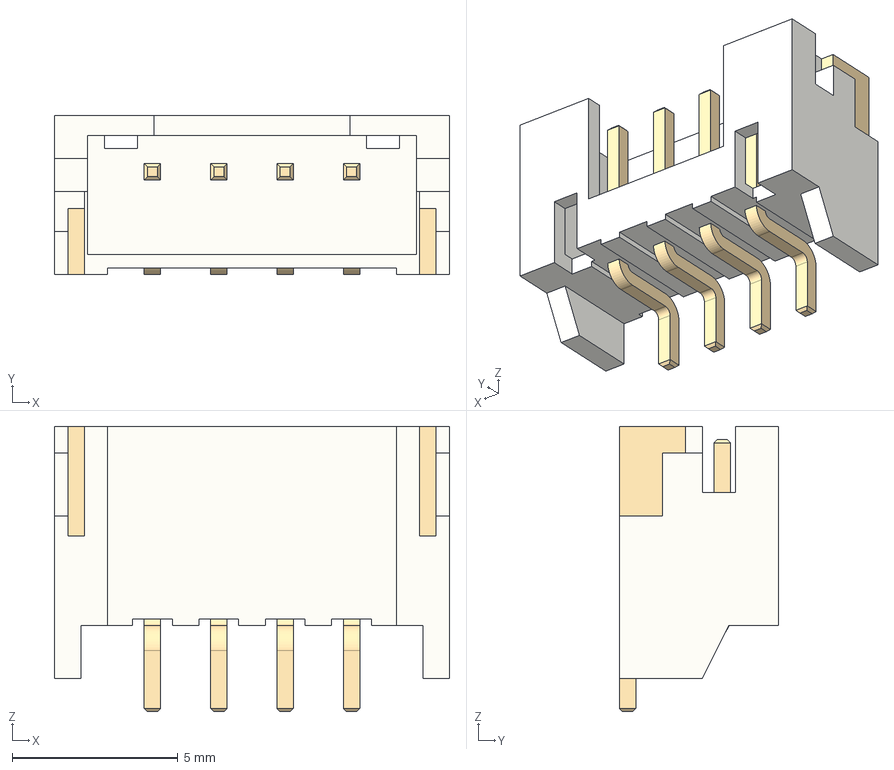
[picture p21: CAD file, 2022-08-28]
3dmodels/JST-PH-S4B-PH-SM4-TB.step
11.9 x 4.80 x 8.60 mm
