wntrblm/winterbloom_kicad_library/3dmodels/SS-7188S-A-PG4-1-BA.step

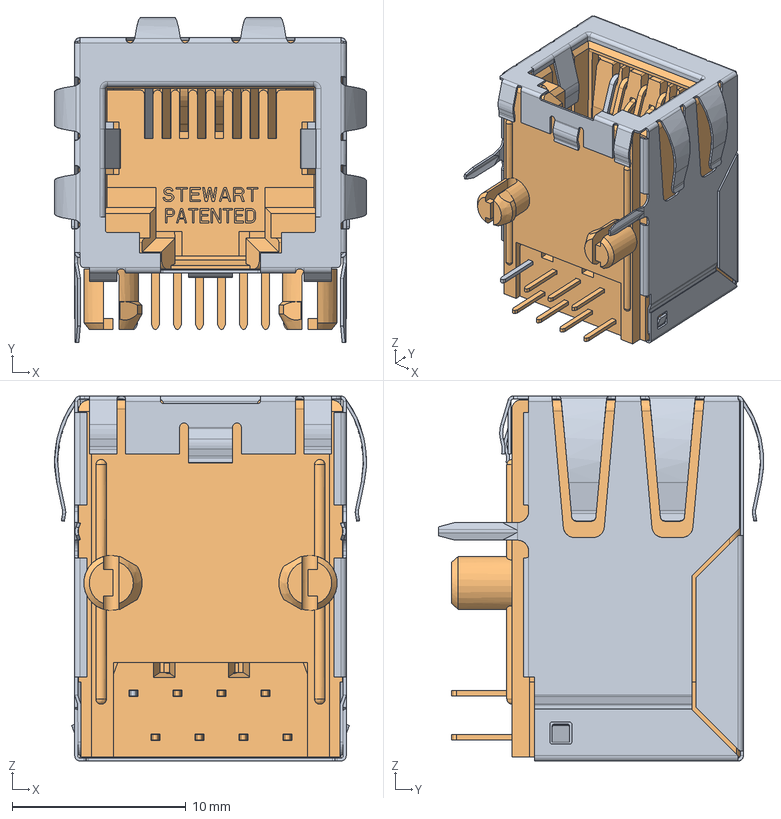
[picture p22: CAD file, 2022-08-06]
3dmodels/SS-7188S-A-PG4-1-BA.step
18.0 x 18.7 x 21.0 mm
SS-7188S-A-PG4-1-BA_PART4
SS-7188S-A-PG4-1-BA_PART3
SS-7188S-A-PG4-1-BA_PART2
SS-7188S-A-PG4-1-BA_PART1
