wntrblm/winterbloom_kicad_library/3dmodels/Alpha-RD901F-40-15R1.step

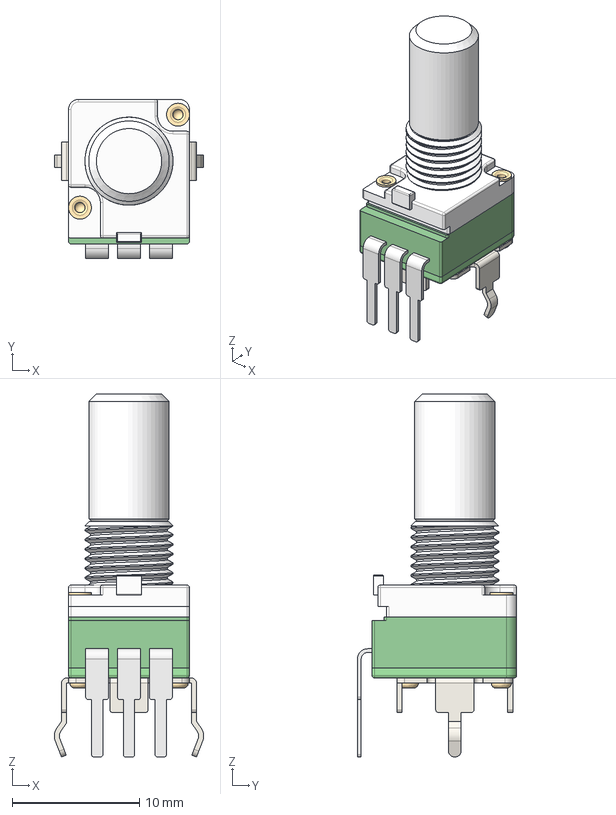
[picture p23: CAD file, 2022-08-06]
3dmodels/Alpha-RD901F-40-15R1.step
11.7 x 12.5 x 28.5 mm
