wntrblm/winterbloom_kicad_library/3dmodels/ASSMANN_A-2014-4-N-R.step

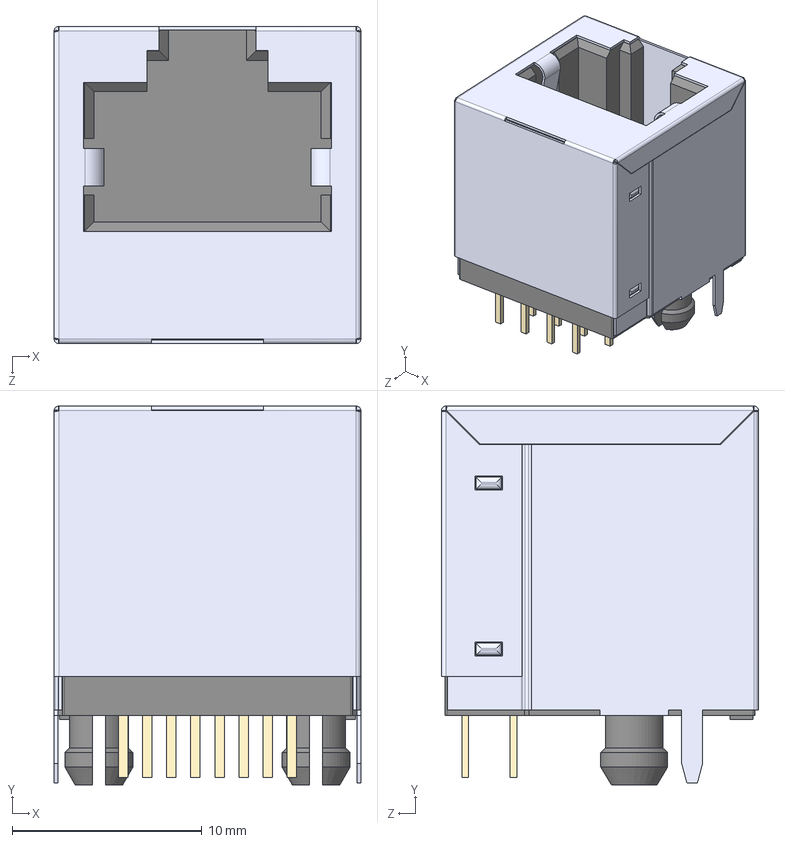
[picture p24: CAD file, 2022-08-06]
3dmodels/ASSMANN_A-2014-4-N-R.step
16.2 x 20.0 x 16.7 mm
