wntrblm/winterbloom_kicad_library/3dmodels/RP2040.step

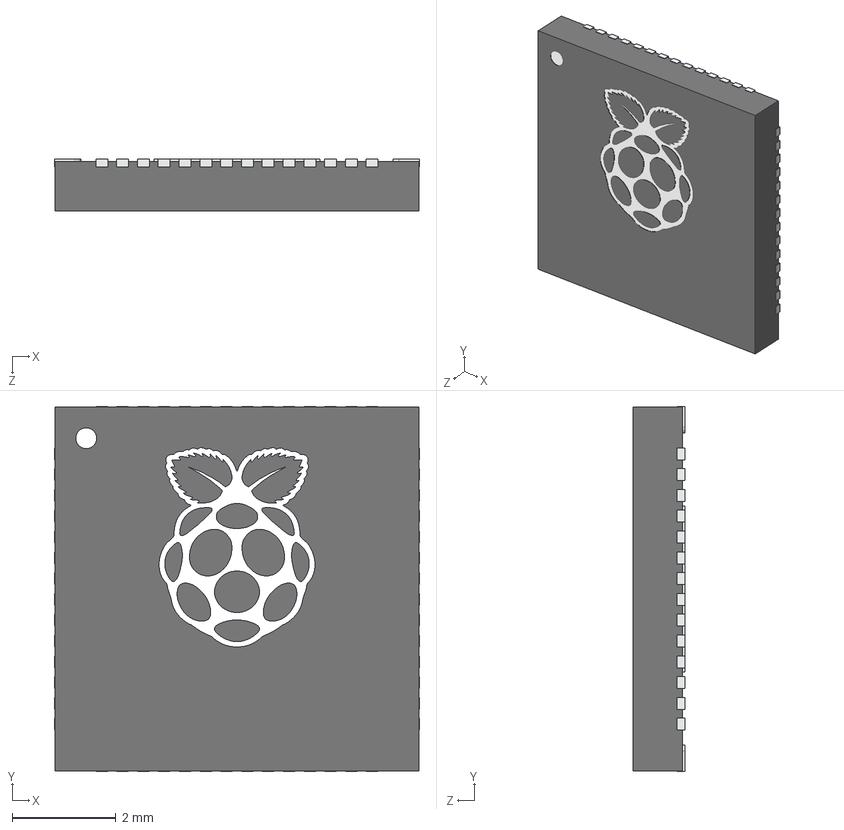
[picture p25: CAD file, 2022-08-06]
3dmodels/RP2040.step
7.02 x 7.02 x 1.00 mm
