wntrblm/winterbloom_kicad_library/3dmodels/Bourns_SDR0403-180ML.step

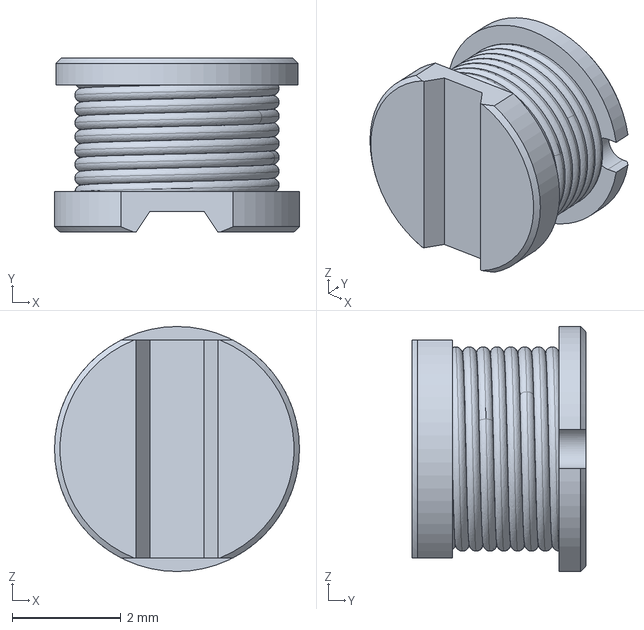
[picture p26: CAD file, 2022-08-06]
3dmodels/Bourns_SDR0403-180ML.step
4.50 x 3.20 x 4.50 mm
