wntrblm/winterbloom_kicad_library/3dmodels/CNC_Tech_3220-10-0300-00.step

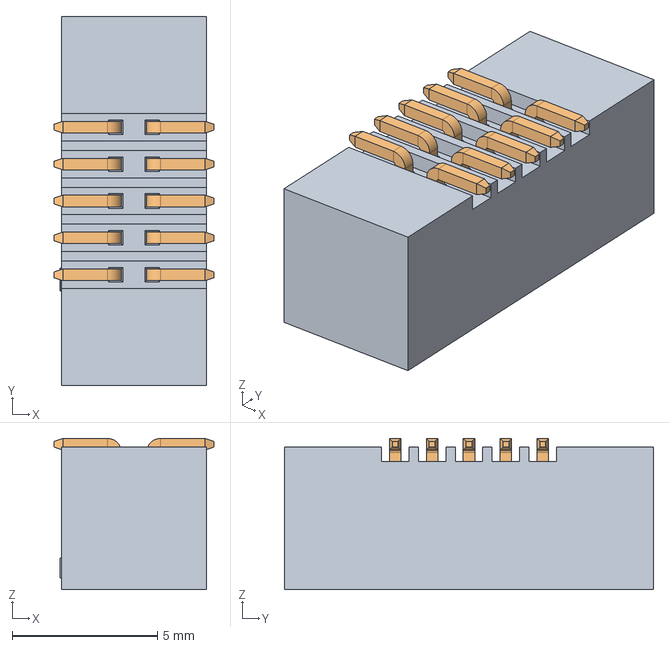
[picture p27: CAD file, 2022-08-06]
3dmodels/CNC_Tech_3220-10-0300-00.step
5.50 x 12.7 x 5.20 mm
802-2195SM-XXG x 10
