wntrblm/winterbloom_kicad_library/3dmodels/Winbond_W25Q128JVS_SOIC_8_5.30mm.step

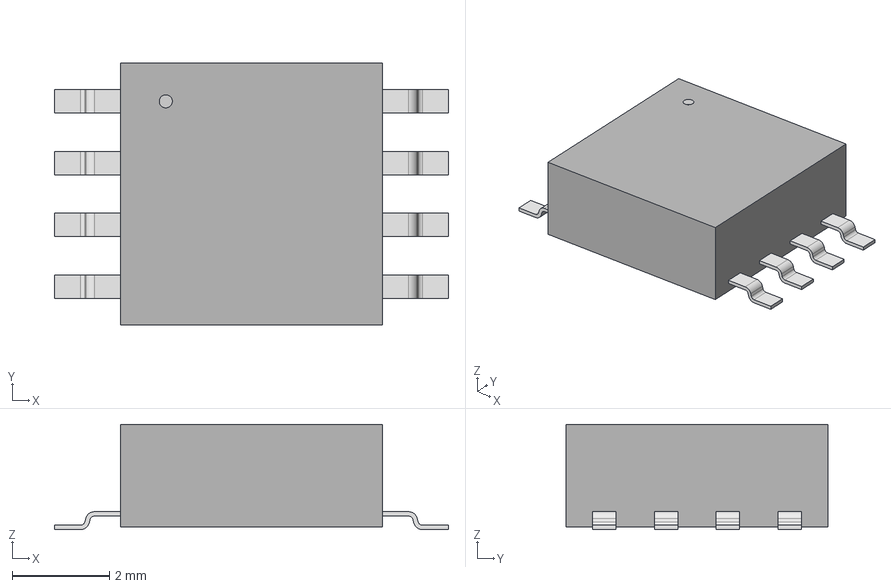
[picture p28: CAD file, 2022-08-06]
3dmodels/Winbond_W25Q128JVS_SOIC_8_5.30mm.step
8.10 x 5.38 x 2.16 mm
