wntrblm/winterbloom_kicad_library/3dmodels/JST-SH-BM08B-SRSS-TB.step

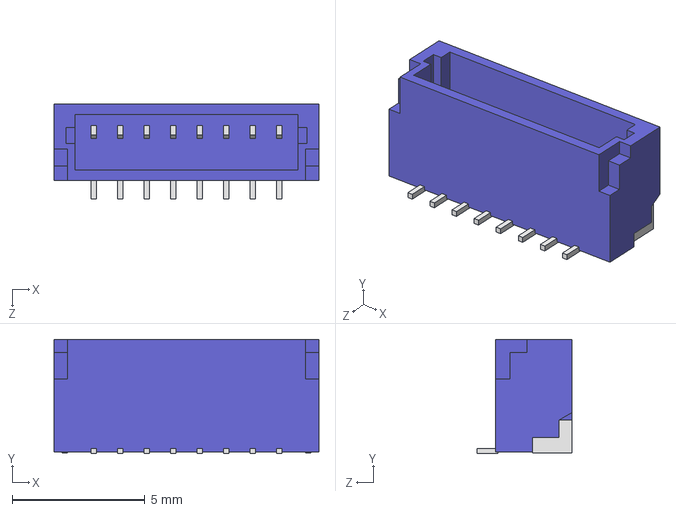
[picture p29: CAD file, 2022-08-06]
3dmodels/JST-SH-BM08B-SRSS-TB.step
10.0 x 4.32 x 3.60 mm
