wntrblm/winterbloom_kicad_library/3dmodels/JST-XH-B4B-A.step

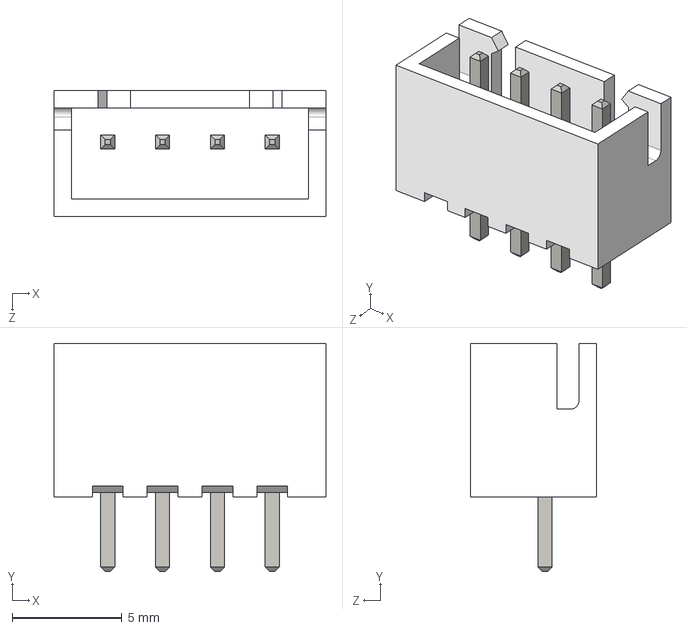
[picture p30: CAD file, 2022-08-06]
3dmodels/JST-XH-B4B-A.step
12.4 x 10.4 x 5.75 mm
B4B-XH-A (BODY)
B4B-XH-A (PIN) x 4
