wntrblm/winterbloom_kicad_library/3dmodels/1255AY-220M-P3.step

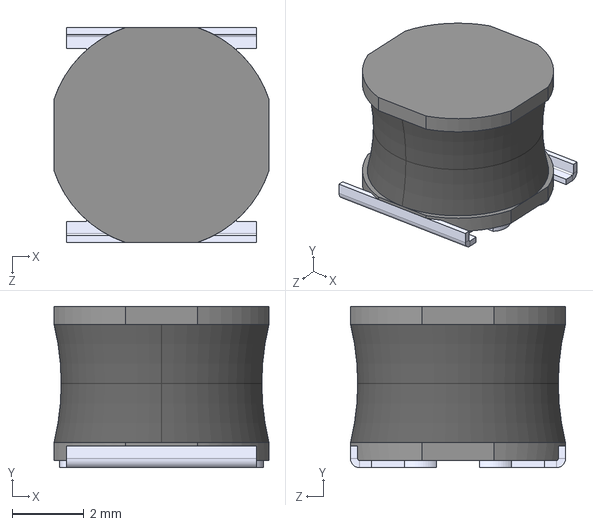
[picture p31: CAD file, 2022-08-06]
3dmodels/1255AY-220M-P3.step
6.00 x 4.50 x 6.00 mm
