wntrblm/winterbloom_kicad_library/3dmodels/E-Switch_1Rxxx.step

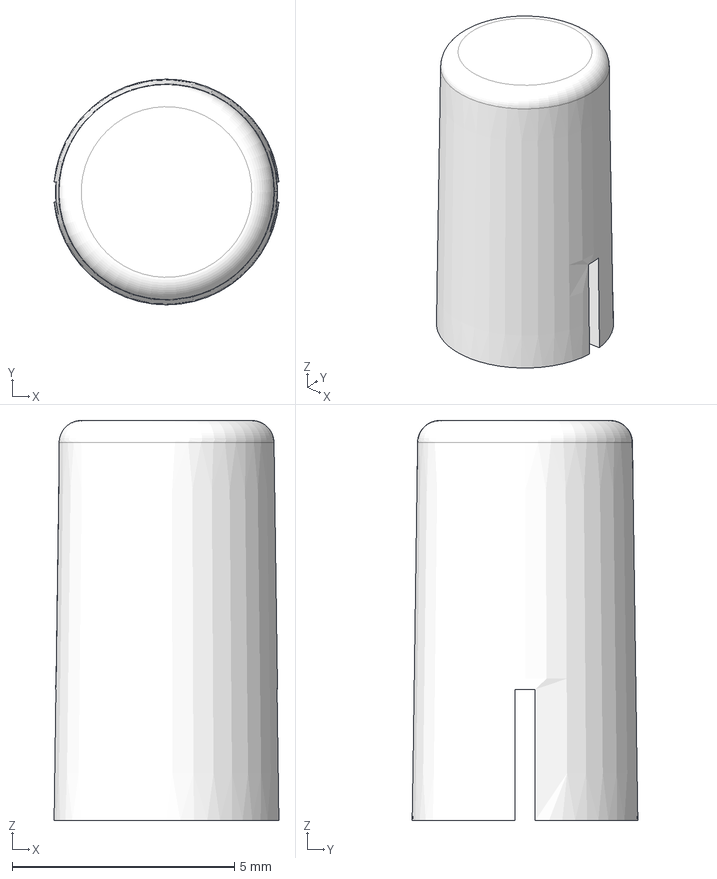
[picture p32: CAD file, 2022-08-06]
3dmodels/E-Switch_1Rxxx.step
5.06 x 5.08 x 9.00 mm
