wntrblm/winterbloom_kicad_library/3dmodels/TMC2209_QFN28_5x5mm.step

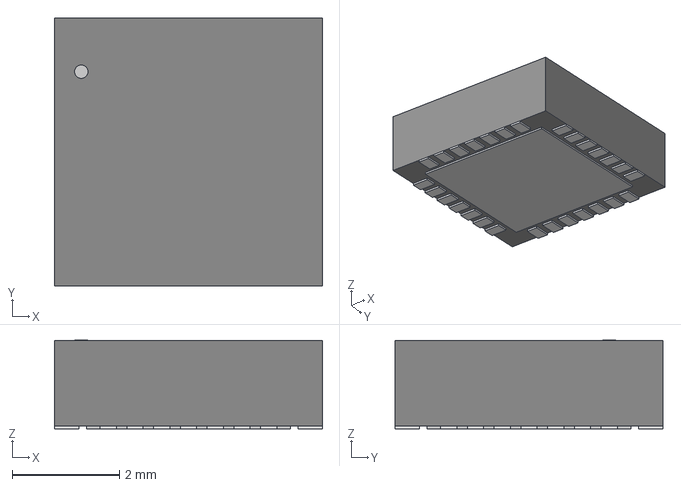
[picture p33: CAD file, 2022-08-06]
3dmodels/TMC2209_QFN28_5x5mm.step
5.00 x 5.00 x 1.65 mm
