wntrblm/winterbloom_kicad_library/3dmodels/Bourns_PTV09A-4x20U-xxxx.stp

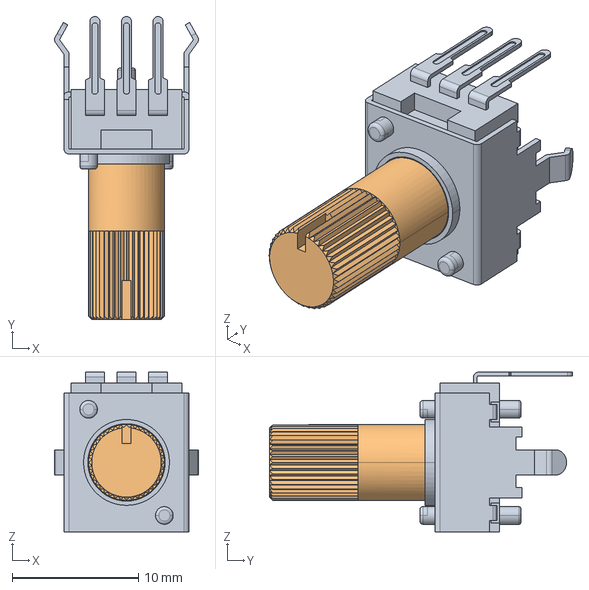
[picture p34: CAD file, 2022-05-23]
3dmodels/Bourns_PTV09A-4x20U-xxxx.stp
11.4 x 24.0 x 12.7 mm
