wntrblm/winterbloom_kicad_library/3dmodels/Bourns_PTV09A-4x30U-xxxx.stp

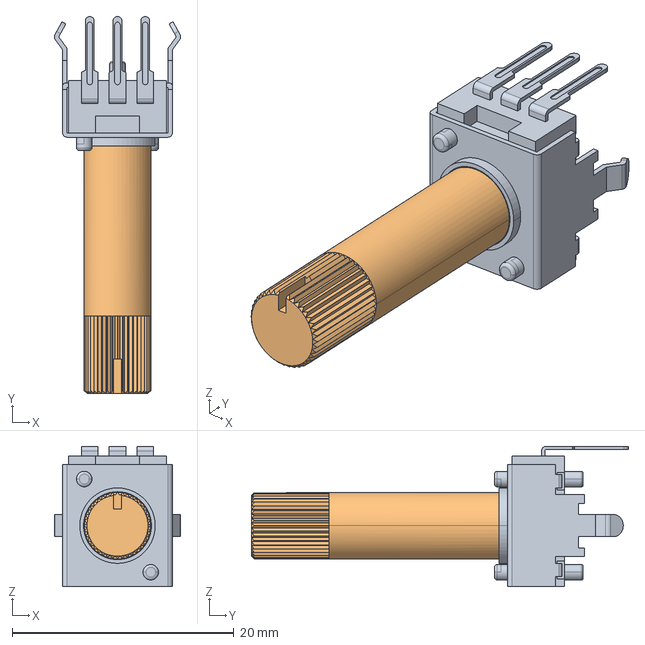
[picture p35: CAD file, 2022-05-23]
3dmodels/Bourns_PTV09A-4x30U-xxxx.stp
11.4 x 34.0 x 12.7 mm
