wntrblm/winterbloom_kicad_library/3dmodels/SOD123W.step

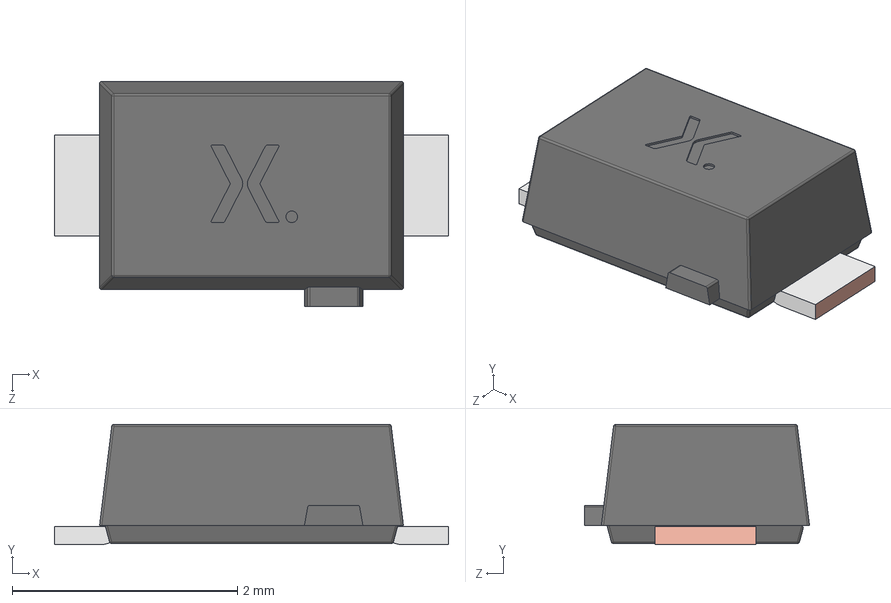
[picture p36: CAD file, 2022-05-23]
3dmodels/SOD123W.step
3.50 x 1.07 x 2.00 mm
SOD123W Lower body
SOD123W Lead x 2
SOD123W Upper body
