wntrblm/winterbloom_kicad_library/3dmodels/Bourns_PTA4543.step

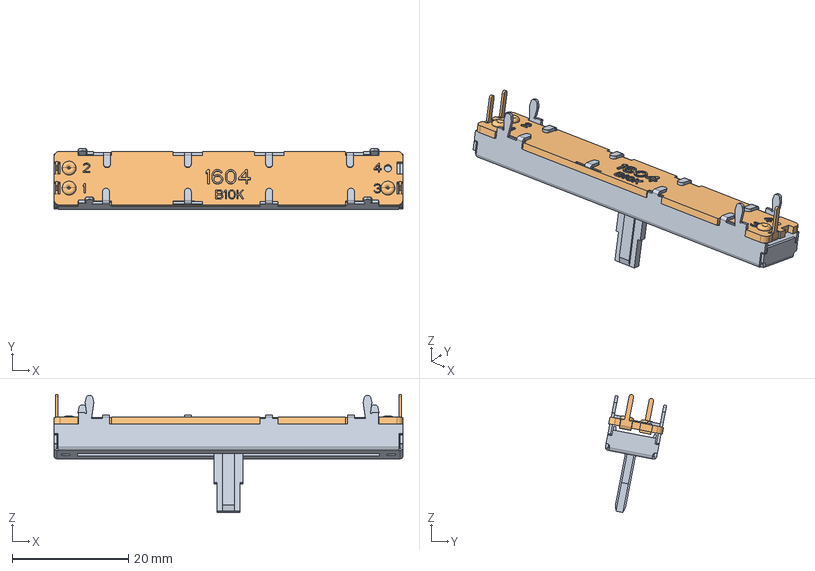
[picture p37: CAD file, 2022-05-23]
3dmodels/Bourns_PTA4543.step
60.0 x 10.6 x 20.3 mm
