wntrblm/winterbloom_kicad_library/3dmodels/Cherry_MX.step

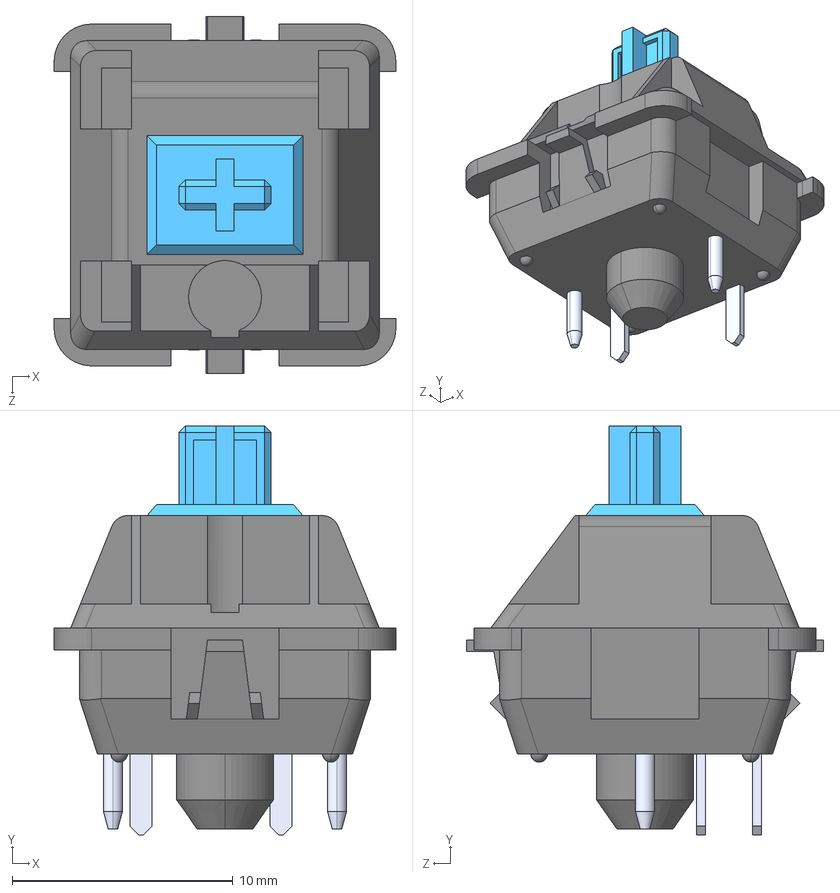
[picture p38: CAD file, 2022-05-23]
3dmodels/Cherry_MX.step
15.5 x 18.5 x 16.2 mm
