wntrblm/winterbloom_kicad_library/3dmodels/CUI_VX7805-500.step

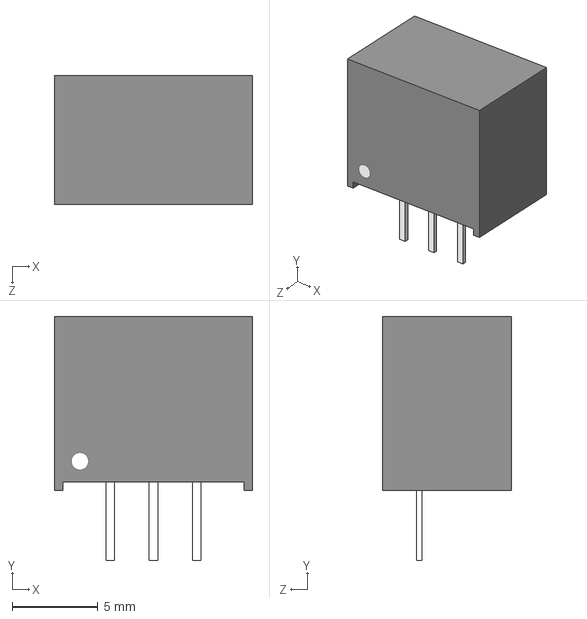
[picture p39: CAD file, 2022-05-23]
3dmodels/CUI_VX7805-500.step
11.6 x 14.3 x 7.55 mm
