wntrblm/winterbloom_kicad_library/3dmodels/AP2012.step

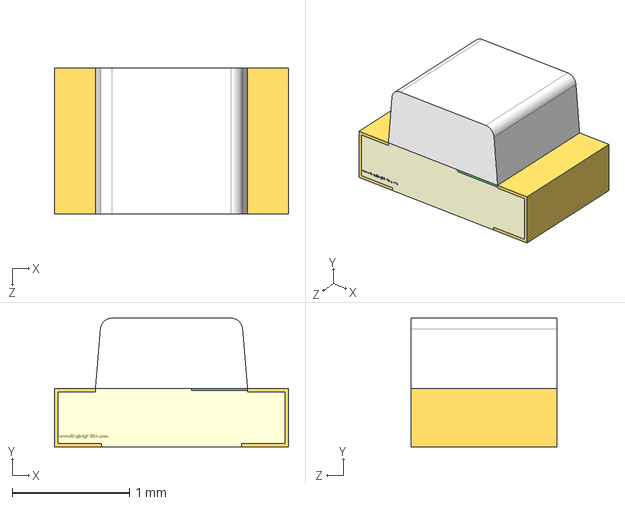
[picture p40: CAD file, 2022-05-23]
3dmodels/AP2012.step
2.00 x 1.10 x 1.25 mm
