wntrblm/winterbloom_kicad_library/3dmodels/APA102_5050.step

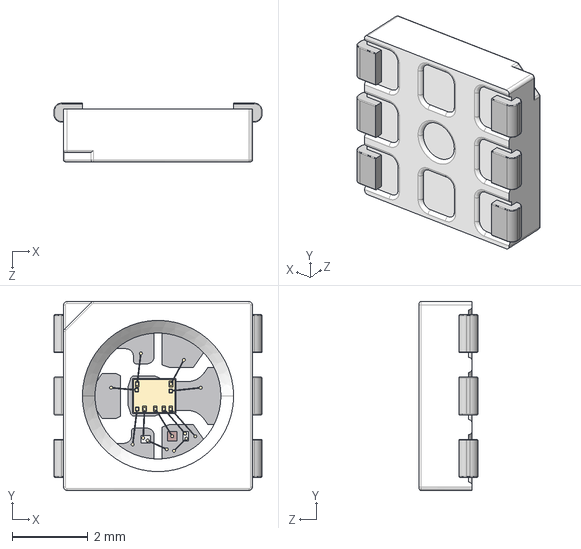
[picture p41: CAD file, 2022-05-23]
3dmodels/APA102_5050.step
5.50 x 5.00 x 1.55 mm
