wntrblm/winterbloom_kicad_library/3dmodels/CUI_P78E12-1000.step

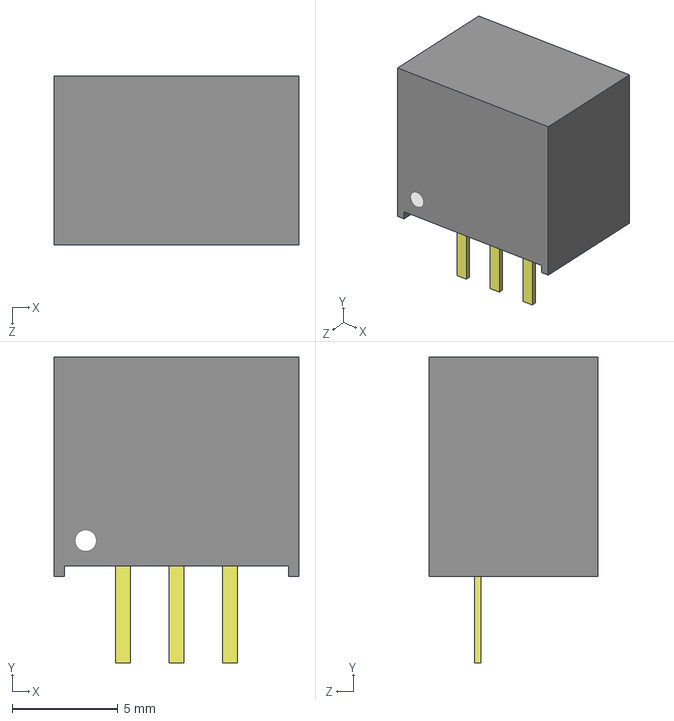
[picture p42: CAD file, 2022-05-23]
3dmodels/CUI_P78E12-1000.step
11.6 x 14.5 x 8.00 mm
