wntrblm/winterbloom_kicad_library/3dmodels/CUI_DEVICES_PJ-102A.step

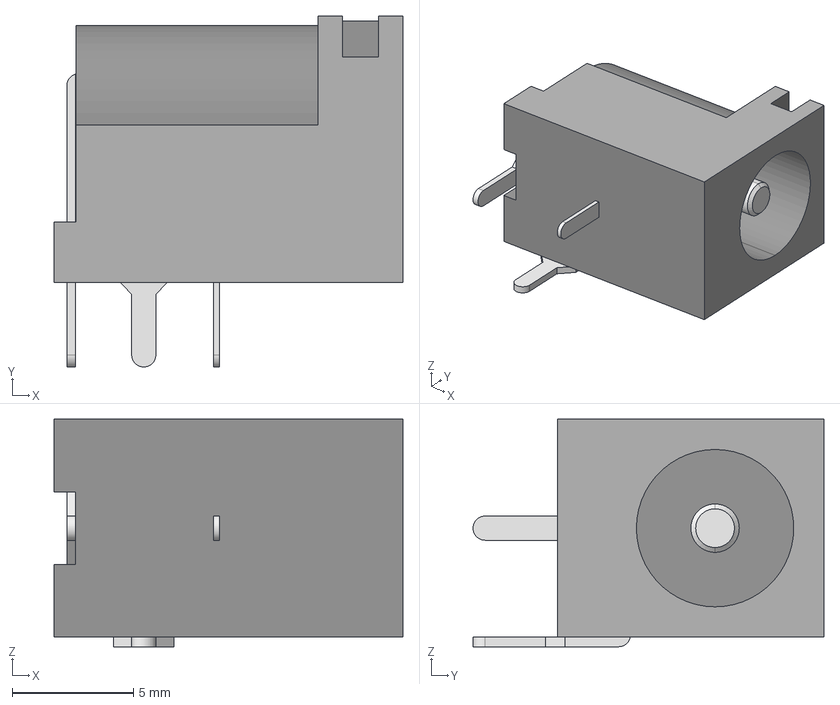
[picture p43: CAD file, 2022-05-23]
3dmodels/CUI_DEVICES_PJ-102A.step
14.4 x 14.5 x 9.40 mm
