wntrblm/winterbloom_kicad_library/3dmodels/Bourns_PTV09A-2x20F-xxxx.step

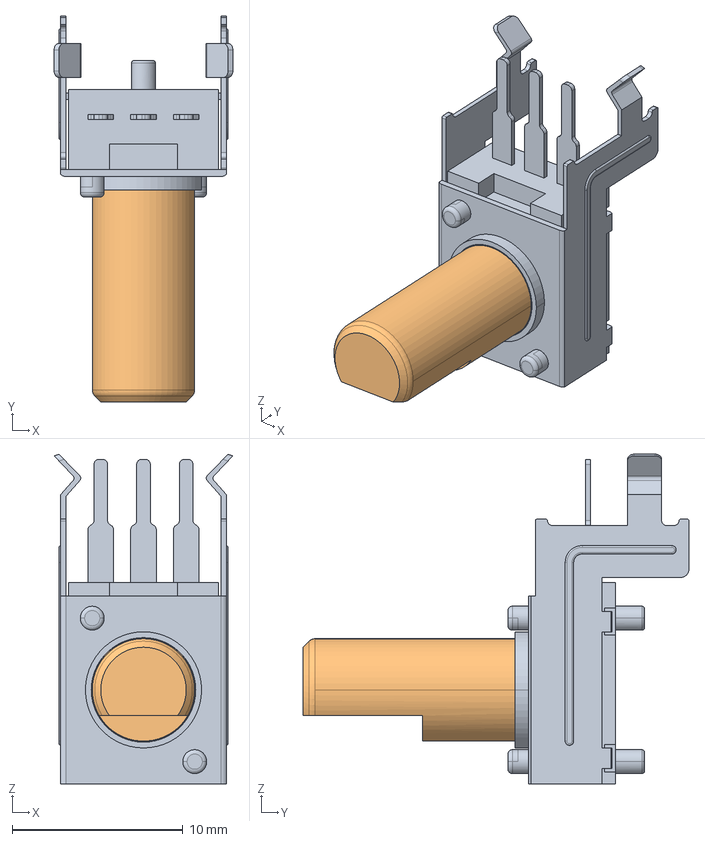
[picture p44: CAD file, 2022-05-23]
3dmodels/Bourns_PTV09A-2x20F-xxxx.step
10.5 x 22.6 x 19.3 mm
