wntrblm/winterbloom_kicad_library/3dmodels/Terminal_Block_01x02.step

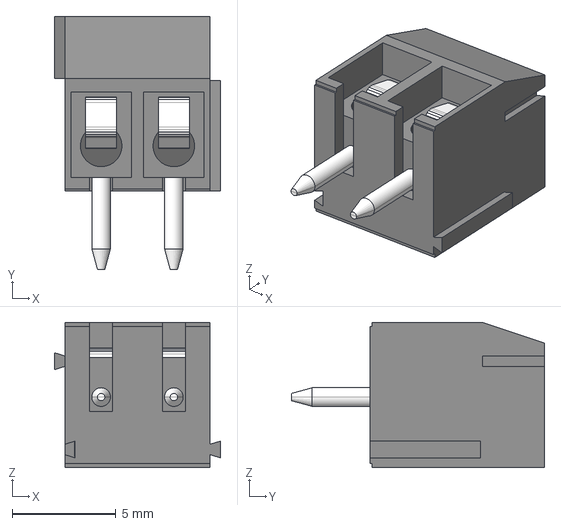
[picture p45: CAD file, 2022-05-23]
3dmodels/Terminal_Block_01x02.step
7.99 x 12.2 x 7.00 mm
