wntrblm/winterbloom_kicad_library/3dmodels/wson-8.step

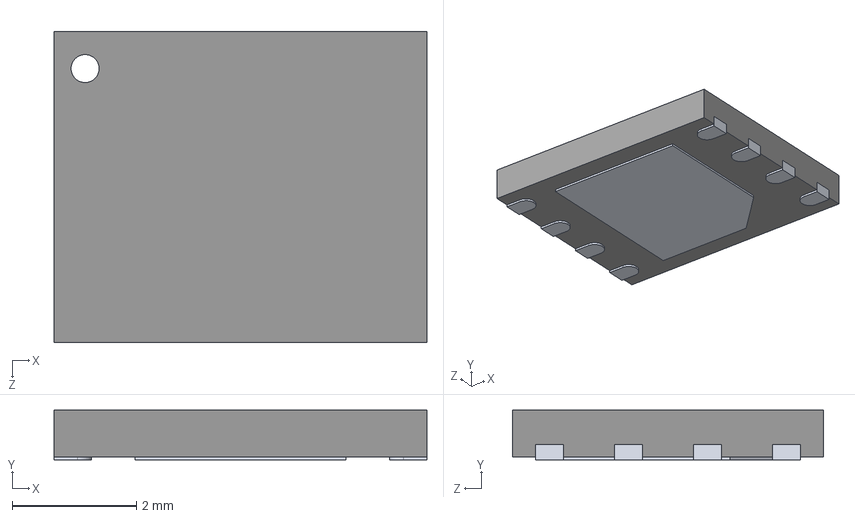
[picture p46: CAD file, 2021-02-13]
3dmodels/wson-8.step
6.00 x 0.8 x 5.00 mm
Case
Power pad
