wntrblm/winterbloom_kicad_library/3dmodels/Eurorack_Power_2x5.step

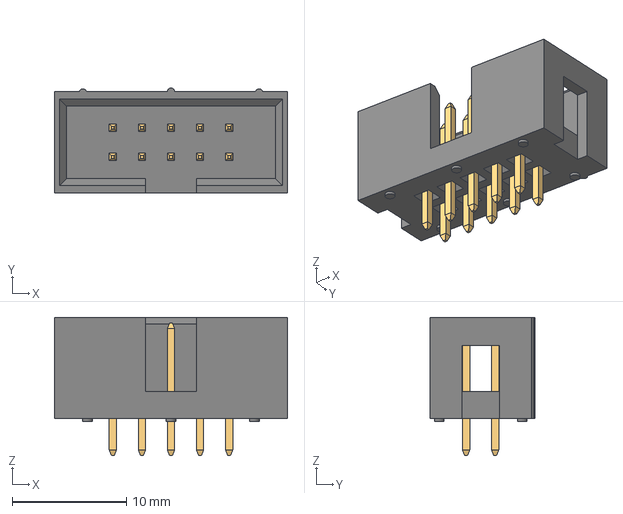
[picture p47: CAD file, 2021-02-13]
3dmodels/Eurorack_Power_2x5.step
20.4 x 9.18 x 12.1 mm
6120xx21621_PIN x 10
