wntrblm/winterbloom_kicad_library/3dmodels/Tactile_Switch_4.2mm.step

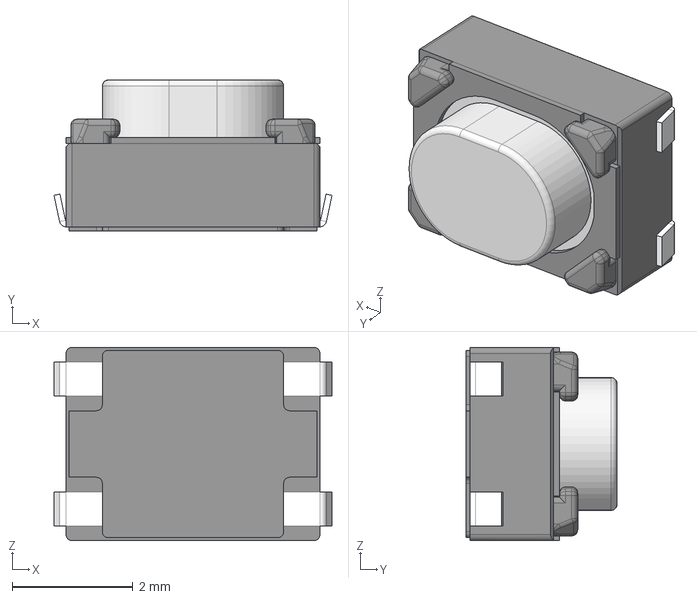
[picture p48: CAD file, 2021-02-13]
3dmodels/Tactile_Switch_4.2mm.step
4.60 x 2.50 x 3.20 mm
