wntrblm/winterbloom_kicad_library/3dmodels/USB_B_Receptacle.step

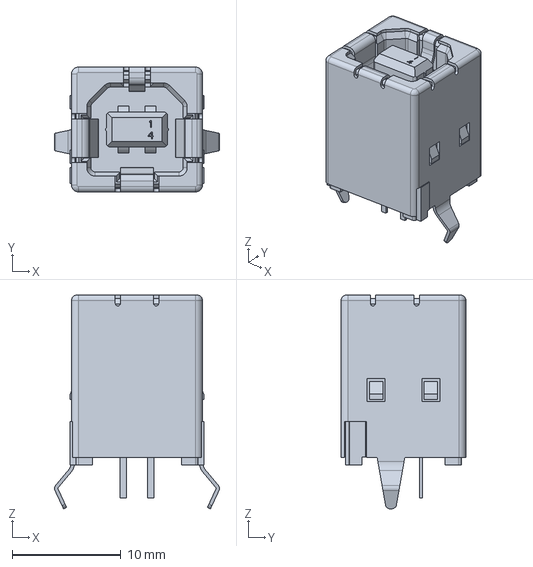
[picture p49: CAD file, 2021-02-13]
3dmodels/USB_B_Receptacle.step
15.1 x 11.5 x 19.6 mm
