wntrblm/winterbloom_kicad_library/(list of files, cad)

Other CAD files:
3dmodels/Bourns_PTV09A-4x20F-xxxx.stp
3dmodels/E-Switch_TL1105TFxxxx.FCStd
3dmodels/WQP-WQP518MA.FCStd
