wntrblm/winterbloom_kicad_library/(commit log)

2021-02-13 Add symbols and 3dmodels
    [WQP-WQP518MA.step, eurorack-power.step, smt_tact.step, usb_b.step, wson-8.step]
2021-09-25 Add footprints for SOD-123, SOD-323, MAX9717B, Eurorack Mounting Holes, Murata PicoBK, TI DGN/VSSOP, WQP518MA-skinny, and CE
2021-10-20 Add SOD-123/SOD-123F, APT2012 LED, and Thonk DPDT switch
2022-01-01 Add courtyard to tact switch footprint
2022-01-01 Add footprint for Littelfuse 0805L
2022-01-01 Add footprint for MPM3610
2022-01-01 Add combined QFN/QFP 64 footprint
2022-01-01 Convert to KiCAD 6.0
2022-01-25 Remove legacy files, update some footprints to better follow guidelines
2022-01-25 Rename some footprints
2022-02-17 Fix pin stacking on the eurorack power symbol
2022-05-23 Massive overhaul of footprints and 3d models
    [AP2012.step, APA102_5050.step, Bourns_PTA4543.step, Bourns_PTV09A-2x20F-xxxx.step, Bourns_PTV09A-4x20F-xxxx.stp, Bourns_PTV09A-4x20U-xxxx.stp, Bourns_PTV09A-4x30U-xxxx.stp, CUI_DEVICES_PJ-102A.step]
2022-08-06 New symbols: - 74HC2G34 - 74LVC2G74 - Conn_SWD - Crystal_12MHz_4Pin - DRV103U - DRV120PWR - LM4040DBZ-10 - TMC2209 - USBLC6-2SC6
    Changed symbols:
    - Tactile_Switch: Changed all pins to passive
    - USB_B_Micro_Receptacle: 5v pin is now power out instead of power in
    New footprints:
    - Connector_Cortex_Debug_IDC_2x05_P1.27mm_Vertical_Shrouded_SMD
    - Connector_RJ45_ASSMANN_A-2014-2S-4-N-R
    - Connector_RJ45_SS-7188S-A-PG4-BA-50
    - Crystal_SMD_HC49-US
    - L_Bourns_SDR0403-180ML
    - L_Murata_1255AY-220M-P3
    - RP2040-QFN-56
    - TMC2209-LA
    Changed footprints:
    - AudioJack_WQP518MA: Added panel cutout outline to F.Fab
    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
    [1255AY-220M-P3.step, ASSMANN_A-2014-4-N-R.step, Alpha-RD901F-40-15R1.step, Bourns_SDR0403-180ML.step, CNC_Tech_3220-10-0300-00.step, E-Switch_1Rxxx.step, E-Switch_TL1105TFxxxx.step, JST-SH-BM08B-SRSS-TB.step]
2022-08-07 Add KiCAD template
    [default.kicad_pcb, default.kicad_sch]
2022-08-08 Add footprints for surface mount passives
2022-08-28 Add 3d model for JST S4B-PH-SM4-TB
    [JST-PH-S4B-PH-SM4-TB.step]
2022-09-14 Modified the following symbols: - Fixed 74HC2G34's pin electrical types - Fixed DRV120's pin electrical types - Fixed MIC5317's overall size
    Added the following symbols:
    - PCA9545
    - RP2040
    - XGZP6857D
    Modified the following footprints:
    - R, C, L, & D footprints now have small illustrations on F.SilkS
    - Renamed DIODE_SOD-123_SOD-123F to D_SOD-123+SOD-123F
    Added the following footprints:
    - D_SMA
    - D_SOD-128
    - JST_SH_SM04B-SRSS-TB_1x04-1MP_P1.00mm_Horizontal
    - JST_XH_B3B-XH-AM_1x03_P2.50mm_Vertical
    - JST_XH_B4B-XH-AM_1x04_P2.50mm_Vertical
    - RJ45_Amphenol_RJE45-188-1411_Vertical
    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
    [Amphenol-RJE45-188-1xx1.step, Belfuse-SS-7188S-A-PG4-BA-50.step, CUI_DEVICES_TB002-500-02BE.step, JST-SH-BM03B-SRSS-TB.step, JST-SH-BM04B-SRSS-TB.step, JST-SH-BM05B-SRSS-TB.step, JST-SH-SM04B-SRSS-TB.step, JST-XH-B3B-A.step]
2022-09-29 Add Conn_01x04_MountingPin2, which allows separate nets for each mounting pin
2023-01-28 Add GHA for generating markdown documentation (#1)
    * ci: add doc gen
    * ci: fix typo
    * docs: kicad-lib-docs
    * docs: add links to symbols and footprints
    ---------
2023-05-25 Change 2x5 power header to locking pads
2023-05-25 Add large 2x5mm solder pad
2023-05-25 docs: kicad-lib-docs
2023-07-19 Update Eurorack_Power footprint (#2)
    This symbol linked to Eurorack_Power_2x5_Shrouded which doesn't look
    present in the footprint library. This is instead replaced with the
    Eurorack_Power_2x5_Shrouded_Lock footprint.
2023-07-20 Add OSHW cert mark footprints
2023-08-08 Update models for WQP-WQP518MA and TL1105, add model for GCT-USB4115-03-C
    [E-Switch_TL1105TFxxxx.FCStd, E-Switch_TL1105TFxxxx.step, WQP-WQP518MA.FCStd, WQP-WQP518MA.step]
2023-09-23 Add G-Switch GT-USB-7038
    [G-Switch_GT-USB-7038B.step, G-Switch_GT-USB-7038D.step]
2023-09-24 Add APA102-2020 footprint and model, add JST SH SM05B model
    [APA102-2020.step, JST-SH-SM05B-SRSS-TB.step]
2024-02-03 Add footprint for Minimoog pot, update AD5686 and SAMD51 symbols
2024-02-03 Add Neutrik NM94HCD2
    [Neutrik_NMJ4HCD2.step]
2024-07-16 Add 3d model for Alps RK09L12
    [Alps_RK09L12-L15V.step]
2024-07-16 Add 3d model for CUI V78E05-500-SMT
    [CUI_V78E05-500-SMT.step]
2024-07-16 Add footprint Converter_DCDC_CUI_V78E05-500-SMT
2024-07-16 Add footprint Connector_FFC_1x05_P2.54mm_Vertical_LongPads.kicad_mod
2024-07-16 Add footprint SOIC-8+DMP-8_5mmx5mm_P1.27mm
