wntrblm/winterbloom_kicad_library/(notices)

Notices in the files:
3dmodels/SS-7188S-A-PG4-1-BA.step:
author */ ('License CC BY-ND 4.0'),
